mmazalov/mmazalov.github.io/fpv/cnc/README.md

# Центральні пластини — завдання на різку

| Файл | Деталь | К-сть |
|---|---|---|
| `plate_top.dxf` | Пластина верхня | 1 |
| `plate_bottom.dxf` | Пластина нижня | 1 |
| `cage_plate_center.dxf` | П1 — монтажна плита між рейками, CF 2 мм | за потребою |
| `cage_plate_side.dxf` | П2 — монтажна плита бортова, **G10 2 мм** | за потребою |

## Матеріал і різка

- **Карбон 3K**, twill або plain, 2.0 мм — центральні пластини і П1
- **Склопластик G10 (FR4), 2.0 мм — П2**; різати з відсмоктуванням пилу
- Одиниці в DXF — **мм**, масштаб 1:1
- Початок координат — лівий нижній кут габариту кожної деталі
- Центральні пластини 250 × 250; П1 190 × 130; П2 150 × 150
- Шар `CUT_OUTER` — зовнішній контур (різати **зовні** лінії)
- Шар `CUT_INNER` — отвори, пази, вирізи (різати **всередині** лінії)
- Допуск на отвори: +0.1 / −0 мм. Ø4.2 під M4, Ø3.2 під M3 — отвори вже з зазором, не розсвердлювати
- Мінімальний внутрішній радіус у контурах — 2.5 мм (фреза до Ø5)
- Кромки зняти від розшарування, фаску не робити

## Орієнтація

Півкруглий виріз R2.5 по центру однієї кромки — **ніс апарата**. Пластини відрізняються
отворами; на обох виріз має дивитись в один бік при складанні.

## Що на пластинах

| Отвори | Ø | Верхня | Нижня |
|---|---|---|---|
| Затискачі променів Ø50, 4×M4 на промінь | 4.2 | 16 | 16 |
| Стійки між пластинами, 50 мм | 3.2 | 4 | 4 |
| Кронштейн Starlink | 4.2 | 4 | — |
| Кронштейн щогли GPS | 4.2 | 2 | — |
| Демпфери Pixhawk | 3.2 | — | 4 |
| Касета батареї — пази 60×4.2 | — | — | 2 |
| Ніжки клітки payload | 4.2 | — | 8 |
| Пази під джгути 40 × 12 | — | 2 | 2 |
| Центральний виріз | — | 80 × 80 R10 | 70 × 50 R10 |

Розрахункова маса: верхня **168 г**, нижня **177 г**.

## Перевірки, які пройшли файли

- кожен отвір не ближче 1.5·d і не ближче 6 мм до кромки
- перемички між отворами, пазами і вирізом не менше 6 мм
- жоден отвір, окрім власних, не потрапляє під затискач променя
- пластина після вирізів лишається одним цілим
- аудит DXF без помилок; площі контурів з файлу збігаються з еталонною геометрією
  (тобто дуги вигнуті в правильний бік)

Файли генеруються скриптом `fpv/tools/make_plates_dxf.py` з `fpv/tools/plate_geometry.py`.
Правити геометрію — тільки там, не в DXF вручну.

## Монтажні плити клітки (П1, П2)

Універсальні: 4 сідла J5 (Ø3.2, 2×M3 крок 28) і сітка Ø3.2 з кроком 20 під будь-яке навісне.
Кількість — під ваше обладнання; отвори під конкретні вироби не потрібні.

## Нижня пластина: пази касети батареї

Два пази 60 × 4.2 під 2×M4 кожен: хід касети ±15 мм уздовж осі апарата для балансування центру мас.
