mmazalov/mmazalov.github.io/fpv/frame-sketch.pdf

Розміри в мм · z = 0 — площина гвинтів · x — вперед (ніс), y — праворуч

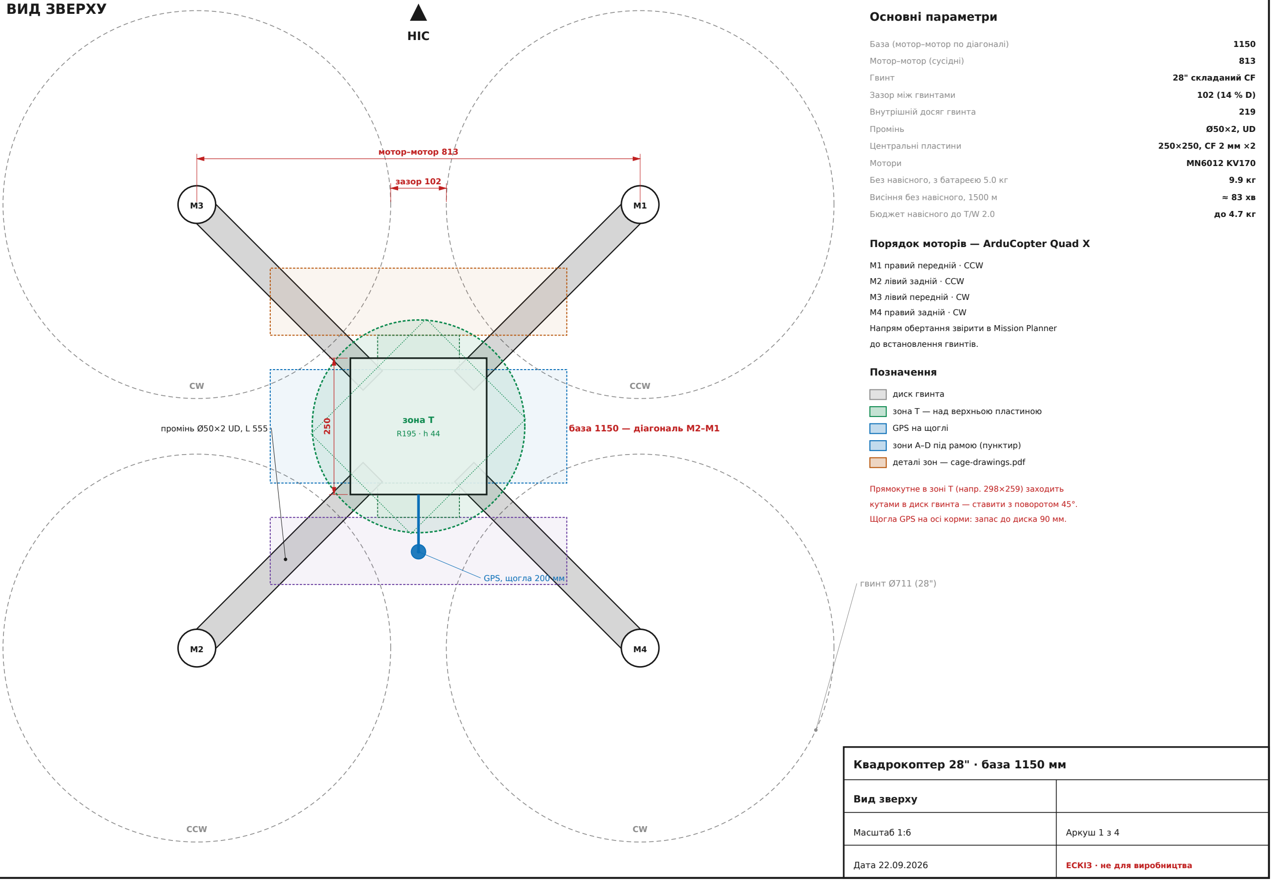
[picture p9: figure]
Квадрокоптер 28" · база 1150 мм; Вид зверху; Масштаб 1:6; Аркуш 1 з 4; Дата 22.09.2026; ЕСКІЗ · не для виробництва; ВИД ЗВЕРХУ; зона T; GPS, щогла 200 мм; CCW; НІС; мотор–мотор 813; зазор 102; промінь Ø50×2 UD, L 555; база 1150 — діагональ M2–M1; гвинт Ø711 (28"); Основні параметри; База (мотор–мотор по діагоналі); Мотор–мотор (сусідні); Гвинт; 28" складаний CF; Зазор між гвинтами; Внутрішній досяг гвинта; Промінь; Центральні пластини; Мотори; Без навісного, з батареєю 5.0 кг; Висіння без навісного, 1500 м; Бюджет навісного до T/W 2.0; Порядок моторів — ArduCopter Quad X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

Напрям обертання звірити в Mission Planner

Прямокутне в зоні T (напр. 298×259) заходить

кутами в диск гвинта — ставити з поворотом 45°.

Щогла GPS на осі корми: запас до диска 90 мм.

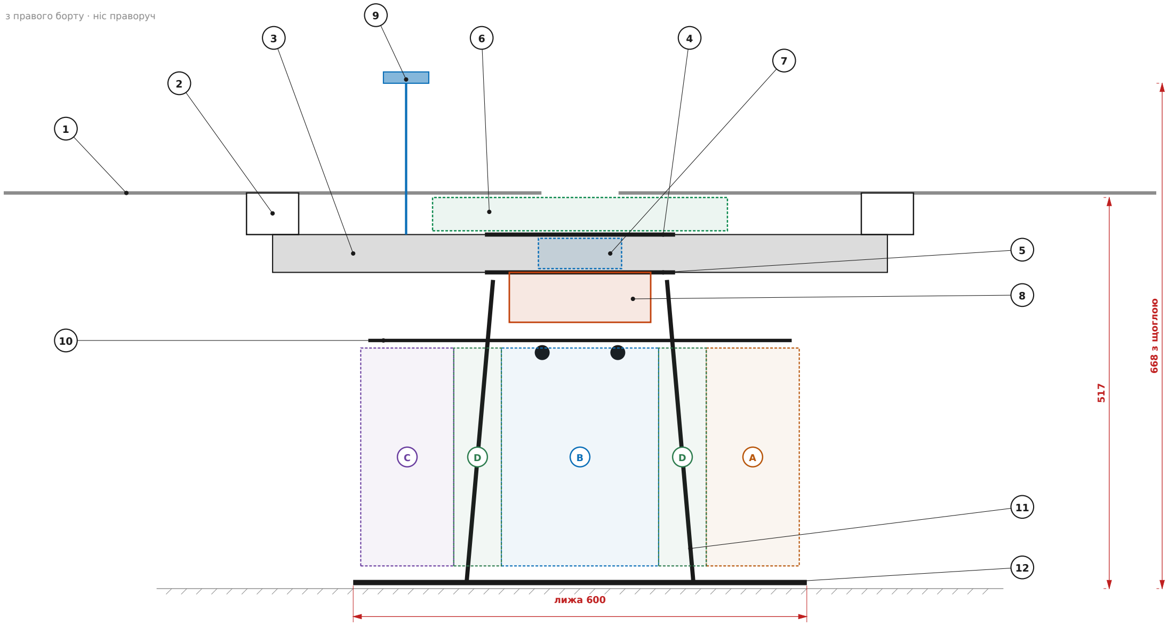
[picture p10: figure]
з правого борту · ніс праворуч; 668 з щоглою; лижа 600

## Квадрокоптер 28" · база 1150 мм

### Вид збоку

Масштаб 1:5 | Аркуш 2 з 4

# ВИД ЗБОКУ

## Рівні, z

GPS, верх | +145
Гвинти | 0
Starlink, верх | −6
Верхня пластина | −55
Вісь променя | −80
Нижня пластина | −105
Низ батареї | −171
Рейки | −195
Поперечки | −211
Верх зон A–D | −205
Низ зон A–D | −493
Низ лиж | −523

### Розв'язки

- Зони навісного: A–D під рамою, T над верхньою пластиною. Габарити й правила — cage-drawings.pdf, аркуші 1–2.
- Клітка payload = шасі. Рейки й поперечки — площина кріплення, зони починаються під нею.
- Просвіт під зонами 30 мм; до ніжок, лиж і батареї — не менше 10 мм.
- Касета батареї в пазах ±15 мм — балансування ЦМ під ваше навісне (±75 кг·мм).
- Авіоніка між пластинами: промені займають лише 4 радіальні смуги, центр вільний, просвіт 50 мм.

## Квадрокоптер 28" · база 1150 мм

### Вид спереду · специфікація

Масштаб 1:5 | Аркуш 3 з 4

# ВИД СПЕРЕДУ

з боку носа · промені обірвано

## Специфікація

Поз. | Найменування | К-сть
1 | Гвинт 28" складаний CF, 2 лоп. | 4

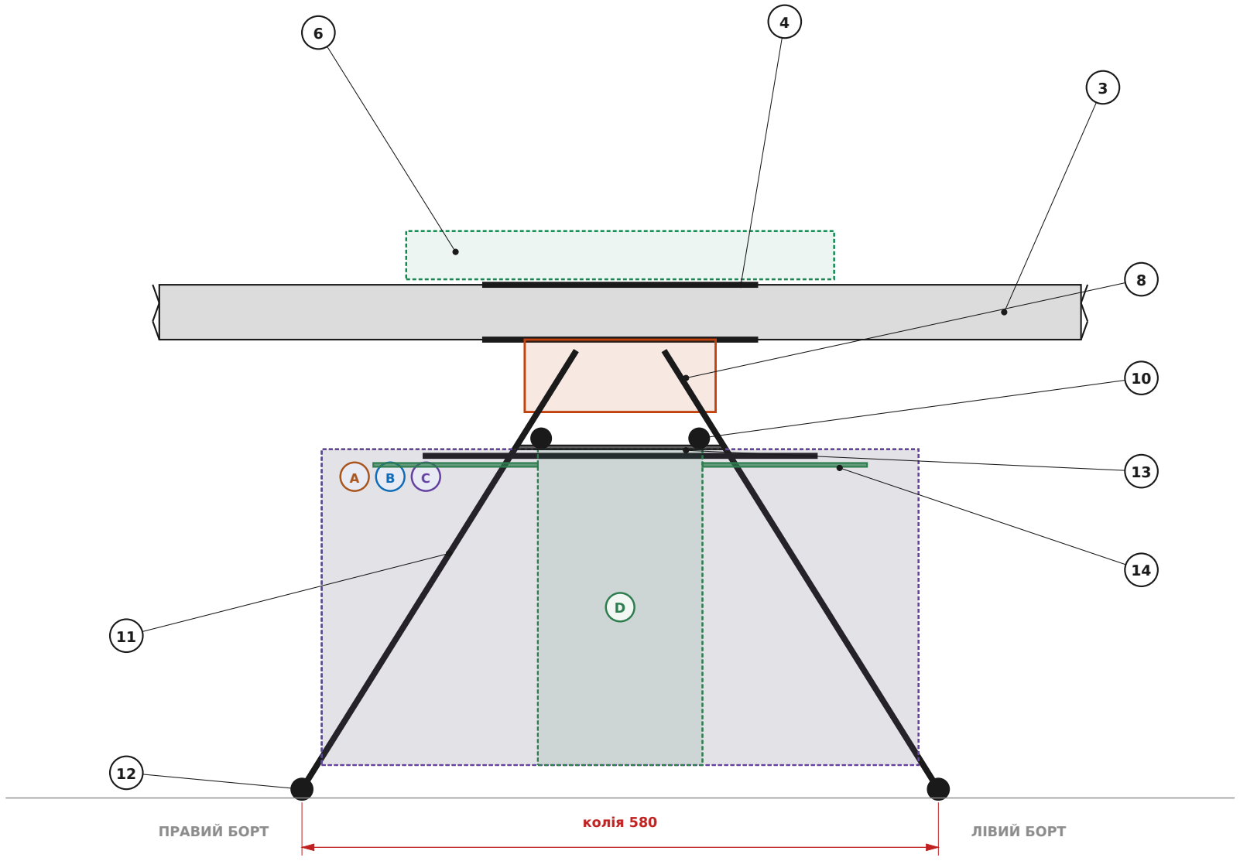
[picture p11: figure]
ПРАВИЙ БОРТ; ЛІВИЙ БОРТ колія 580

2 | Мотор T-Motor MN6012 KV170 | 4
3 | Промінь CF Ø50×2 UD, L 555 | 4
4 | Пластина верхня CF 2 мм 250×250 | 1
5 | Пластина нижня CF 2 мм 250×250 | 1
6 | Зона T — верхнє навісне, 4×M4 | —
7 | Pixhawk 6X + RPi CM4 baseboard | 1
8 | Батарея 12S1P у касеті G10 | 1
9 | Щогла GPS, h 200 | 1
10 | Рейки й поперечки G10 Ø16×14 | 4
11 | Ніжка клітки CF Ø16×14, L 457 | 4
12 | Лижа CF Ø16, L 600 | 2
13 | Монтажна плита між рейками, CF 2 | за потр.
14 | Монтажна плита бортова, G10 2 | за потр.

### Примітки

- Зони A, B, C мають однаковий переріз у цьому виді; D — вузький коридор між ніжками (±75).
- Колія лиж 580 ≥ 550 — стійкість на ухилі з батареєю 5 кг під центром.
- Антени нижче 1 ГГц — у бортових частинах зон, ≥ λ/4 (83 мм на 900 МГц) від карбону й металу.
- Монтажні плити (поз. 13, 14) — приклади; кількість і положення — під ваше навісне.

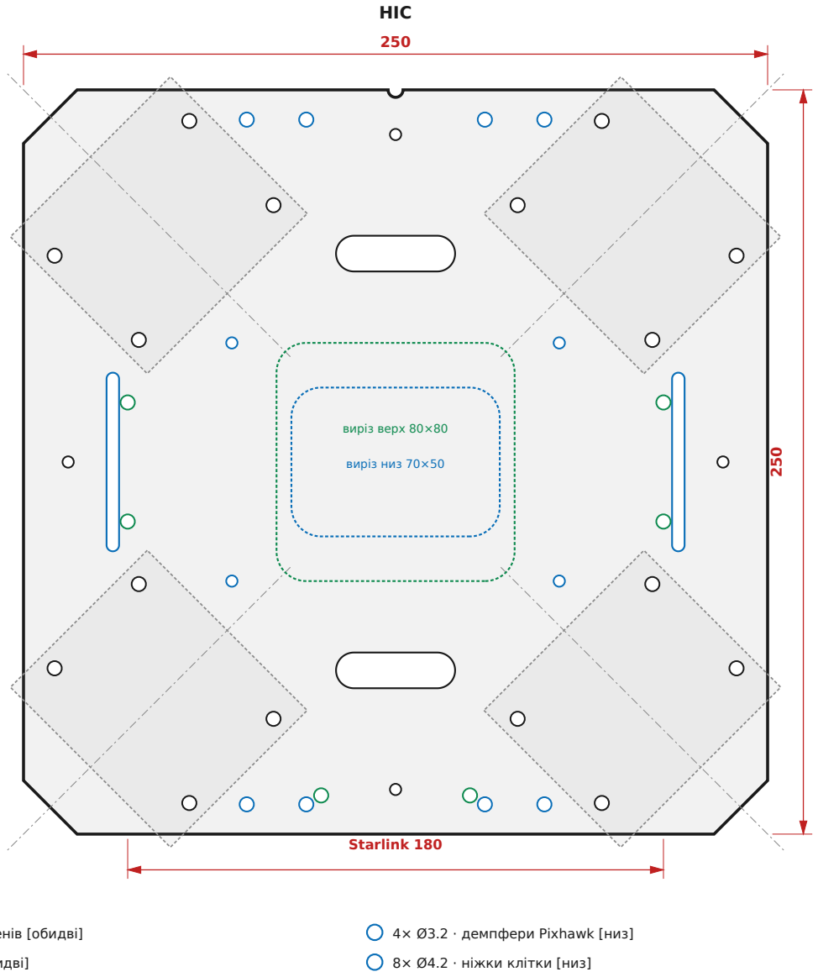
[picture p12: figure]
виріз верх 80×80; виріз низ 70×50; НІС; Starlink 180; 4× Ø3.2 · демпфери Pixhawk [низ]; 8× Ø4.2 · ніжки клітки [низ]

## Квадрокоптер 28" · база 1150 мм

### Зони встановлення · центральна пластина

Масштаб 1:4 / 1:2 | Аркуш 4 з 4

# ЗОНИ ВСТАНОВЛЕННЯ — ПЛАН

проекція на вид зверху · рама фантомом

### НІС

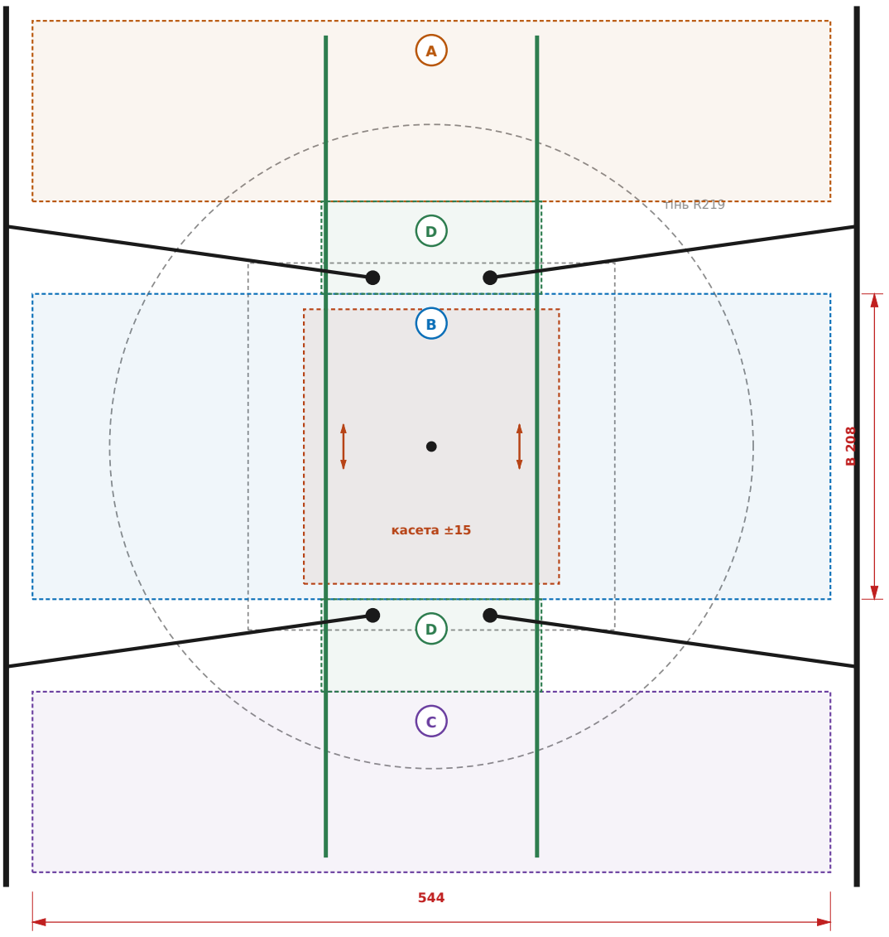
[picture p13: figure]
касета ±15; тінь R219

580 (A–D уздовж)

Зони: A носова 123×544, B центральна 208×544, C кормова 123×544, D коридори 63×150 (×2); висота 288.

ЦМ: касета батареї в пазах ±15 мм компенсує ±75 кг·мм по x. По y компенсації немає.

# ЦЕНТРАЛЬНА ПЛАСТИНА

CF 2 мм · 2 шт · вид зверху · для DXF брати розміри, не масштаб

### Отвори

16× Ø4.2 · затискачі променів [обидві]

4× Ø3.2 · стійки 50 мм [обидві]

4× Ø4.2 · кронштейн Starlink [верх]

2× Ø4.2 · кронштейн щогли GPS [верх]

Затискач Ø50: 4×M4, крок 40 уздовж × 64 впоперек. Пази 40×12 — під джгути.

Пластина 250×250 (на 210×200 затискачі Ø50 не поміщаються): верх 168 г, низ 176 г.

Нижня: 2 пази касети 60×4.2 під 2×M4 кожен — хід ±15 мм. Півкруглий виріз на кромці — ніс.

DXF для різки: fpv/cnc/plate_top.dxf, plate_bottom.dxf.
