mmazalov/mmazalov.github.io/fpv/cnc/plate_bottom.dxf

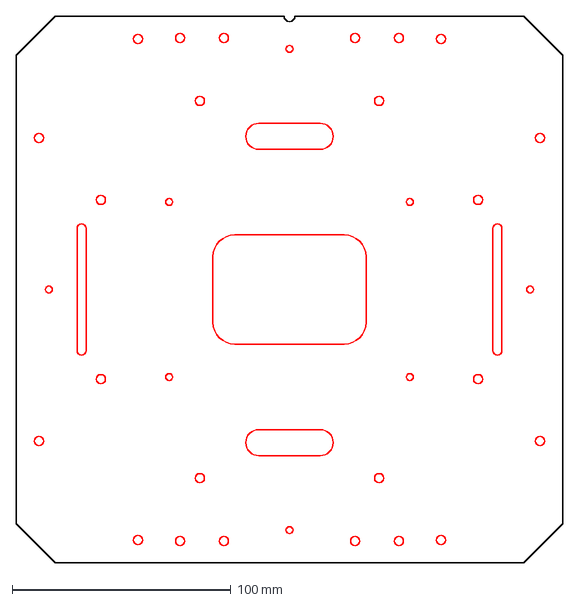
[picture p14: CAD file, 2026-09-22]
fpv/cnc/plate_bottom.dxf
250.0 x 250.0 mm
