mmazalov/mmazalov.github.io/fpv/cnc/cage_plate_side.dxf

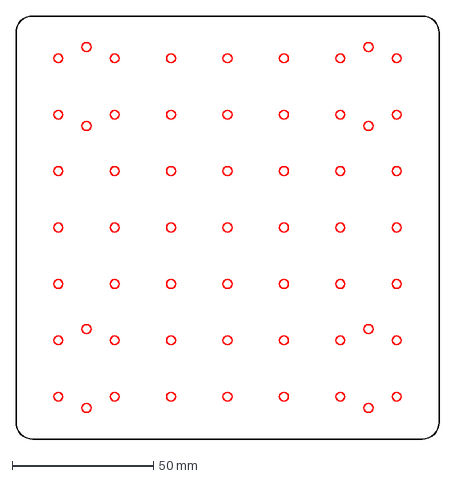
[picture p15: CAD file, 2026-09-22]
fpv/cnc/cage_plate_side.dxf
150.0 x 150.0 mm
