mmazalov/mmazalov.github.io/fpv/cnc/plate_top.dxf

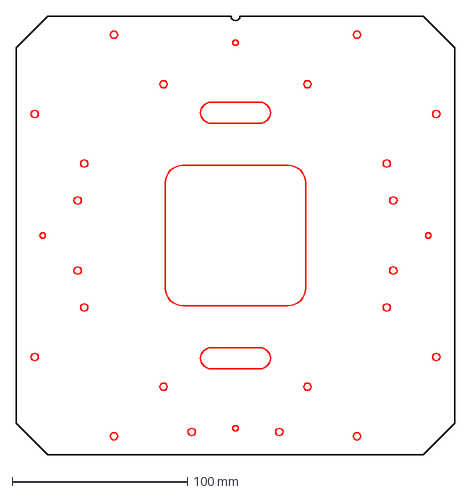
[picture p16: CAD file, 2026-09-22]
fpv/cnc/plate_top.dxf
250.0 x 250.0 mm
