mmazalov/mmazalov.github.io/fpv/cnc/cage_plate_center.dxf

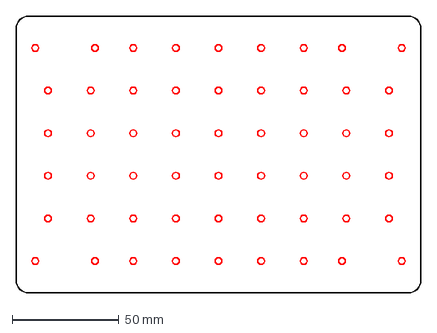
[picture p17: CAD file, 2026-09-22]
fpv/cnc/cage_plate_center.dxf
190.0 x 130.0 mm
