mmazalov/mmazalov.github.io/fpv/cnc/cage_horn.dxf

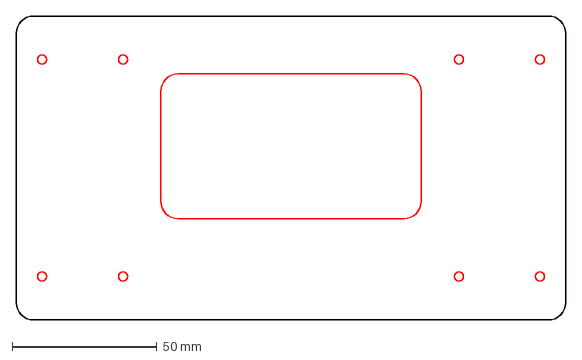
[picture p18: CAD file, 2026-09-22]
fpv/cnc/cage_horn.dxf
190.0 x 105.0 mm
