mmazalov/mmazalov.github.io/fpv/cnc/cage_zr10.dxf

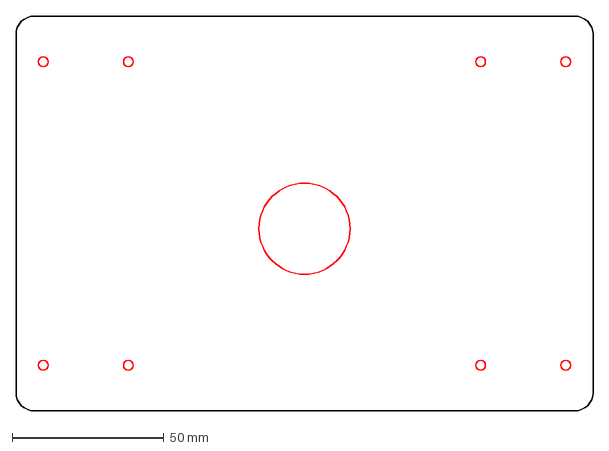
[picture p19: CAD file, 2026-09-22]
fpv/cnc/cage_zr10.dxf
190.0 x 130.0 mm
