mmazalov/mmazalov.github.io/fpv/longrange-build.md

# FPV довготривалого висіння — робоча специфікація

**Задача:** стабільне висіння на 1000–1500 м, 50–60 хв, з каналом Starlink
і антенним payload 3.3 ГГц / 900 МГц.

Креслення: `frame-24in-layout.svg` (потребує оновлення під базу 1100 мм)

---

## 0. ФІНАЛЬНА КОНФІГУРАЦІЯ

Розділи 1–10 нижче — хід міркувань і причини кожної зміни. Ця секція — те, що замовляти.

| Вузол | Рішення |
|---|---|
| Схема | квадр X, **база 1150 мм** (§19.5) |
| Гвинти | **28" складані CF**, 2-лопатеві — 26" не проходить по тязі (§19.2) |
| Мотори | **T-Motor MN6012 KV170** ×4 |
| ESC | APD 80F3[X] або T-Motor Alpha 80A HV ×4 |
| Промінь | карбон **кругла Ø50×2 мм, roll-wrapped, UD-домінантний**, заготовка 515 мм (§17) |
| Батарея | **12S1P Westinghouse INP1187187** Li-ion pouch, 1732 Вт·год, маса до уточнення (§12) |
| Зв'язок | Starlink Mini + buck 24 В / 150 Вт |
| **Керування** | **ELRS 2.4 ГГц — НЕ 868 МГц** (конфлікт з payload, §10.1) |
| Відео | DJI O4 Air Unit |
| Payload | рупор 3.3 ГГц 16 dBi (корма) + Ягі 900 МГц 5 ел. + ретранслятор + **SIYI ZR10 (ніс)** |
| Політний контролер | **Pixhawk 6X + Raspberry Pi CM4 Baseboard** (§19.1). F722 не підходить |
| Шасі | **клітка payload 400 мм**, вона ж посадкові опори (§16) |

### Розрахункові показники

| Параметр | Значення |
|---|---|
| Суха маса | 6.05 кг |
| Комірка | Westinghouse INP1187187, 39 Ач, 175 А, 144.3 Вт·год |
| **AUW** | **13.8 кг** з payload і реальною кліткою (§23) |
| Тяга в висінні | 2763 г/мотор |
| Потужність на 1500 м | 1406 Вт (31.7 А, 0.81C) |
| **Час висіння на 1500 м** | **47.5 хв** з повним payload, пакет 5.0 кг (§23) |
| T/W на 1500 м | 2.50 |
| Лопатева частота | 87.8 Гц |
| Мода променя 40×40×2 UD | 126 Гц (запас 1.43×) |
| ЦМ | 97 мм нижче площини гвинтів |

### Електричний баланс

| Споживач | Потужність | Частка |
|---|---|---|
| Гвинтомоторна група | 1300 Вт | 92 % |
| Starlink Mini | 39 Вт | 3 % |
| Payload RF | 42 Вт | 3 % |
| Авіоніка, FC, GPS, O4 | 25 Вт | 2 % |
| **Разом** | **1406 Вт** | |

### Альтернативи, якщо змінити два рішення

| Варіант | AUW | Час | T/W |
|---|---|---|---|
| **Пласкі антени, 26"** | **11.05 кг** | **62 хв** | **2.50** |
| Пласкі антени, 24" (база 1000) | 11.05 кг | 57 хв | 2.19 |
| Рупор + Ягі, 26" | 11.49 кг | 59 хв | 2.41 |
| Рупор + Ягі, 24" (база 1000) | 11.49 кг | 54 хв | 2.11 |

### Три речі, які не можна змінювати мовчки

1. **Керування на 2.4 ГГц.** 868 МГц лежить за 3.7 % від payload-передавача на 900 МГц.
   Фільтром не розділяється, наслідок — втрата керування. §10.1
2. **Труба UD-домінантна, 40×40×2.** Квазіізотропна дасть моду на лопатевій частоті. §10.4
3. **Пороги батареї за паспортом solid-state, не за аналогією з Li-ion.** §9

### Орієнтовний бюджет (без батареї і payload RF)

| | грн |
|---|---|
| Мотори MN6012 ×4 | 54 000 |
| ESC 80 A ×4 | 18 000 |
| Гвинти 26" складані, 3 пари | 13 000 |
| Рама DIY (40×40, пластини, CNC, шасі) | 20 000 |
| Pixhawk 6C + GPS + power module | 15 300 |
| Starlink Mini + buck + кронштейн | 23 500 |
| DJI O4 Air Unit | 12 000 |
| ELRS 2.4 ГГц RX + TX | 5 000 |
| Силова частина, роз'єми, дрібниця | 5 000 |
| **Разом** | **≈ 166 000** |

Зарядка Junsi iCharger X12 — ще 12 000, якщо немає.

---

## 1. Підсумок

| Параметр | Значення |
|---|---|
| Схема | квадр X, база 1000 мм |
| Гвинти | 24" складані CF, 2-лопатеві (Ø610 мм) |
| Мотори | T-Motor MN6007 II KV160, 12S |
| ESC | Flycolor X-Cross HV3 60A 5-12S BLHeli_32 ×4 |
| Батарея | 12S4P Samsung INR21700-50S — 864 Вт·год, 3.97 кг |
| Суха маса | 3.06 кг |
| **AUW** | **7.03 кг** |
| Тяга в висінні | 1758 г/мотор (35 % від максимуму) |
| T/W на 1500 м | 2.46 |
| Потужність висіння на 1500 м | 740 Вт (17.1 А) |
| **Час висіння на 1500 м** | **56–61 хв** (номінал 59) |

---

## 2. Розрахунок

Теорія імпульсу, на один мотор:

```
A       = π · (D·0.0254/2)²           площа диска, м²
T_N     = T_g · 0.00981               тяга, Н
P_ideal = T_N^1.5 / sqrt(2·ρ·A)       ідеальна потужність
P_elec  = P_ideal / (FM · η_drive)    спожита з батареї
```

`FM·η_drive` — добуток ККД гвинта і приводу, єдиний коефіцієнт, який вирішує все.
Калібрування по DJI M350 RTK (6.47 кг, 21", 620 Вт·год, 55 хв) → 0.56, верхня межа серійної
техніки. Для збірки на T-Motor MN6007 II + якісні складані CF гвинти приймаємо **0.51**.

Висота 1500 м: ρ = 1.058 кг/м³, `P ∝ 1/sqrt(ρ)` → +7.6 % потужності. Плюс ~3 хв на набір.
Li-ion розряджаємо до 3.2 В/комірку → корисних 88 % ємності.

### Вибір ємності батареї

| Пакет | Маса | Ємність | AUW | Потужність | Час | T/W @1500м |
|---|---|---|---|---|---|---|
| 12S3P | 2.98 кг | 648 Вт·год | 6.04 кг | 594 Вт | 55 хв | 2.87 |
| **12S4P** | **3.97 кг** | **864 Вт·год** | **7.03 кг** | **740 Вт** | **59 хв** | **2.46** |
| 12S5P | 4.97 кг | 1080 Вт·год | 8.02 кг | 896 Вт | 61 хв | 2.15 |

Плато очевидне: 12S5P додає 1 кг і ~4 600 грн заради +2 хв, і псує керованість.
**12S4P — оптимум.**

### Чутливість

| Фактор | Вплив |
|---|---|
| 22" → 24" гвинти | **+5 хв** (804 Вт → 740 Вт) |
| FM·η_drive 0.47 → 0.53 | 54 → 61 хв |
| Кожні 100 г сухої маси | **∓1.3 хв** |

Кожні 100 г рами коштують 1.3 хв. Кожні 100 г батареї дають лише +0.2 хв.
**Економія маси рами у 6 разів ефективніша за додавання батареї.**

---

## 3. Рама

### Геометрія

| Розмір | Значення |
|---|---|
| База (діагональ мотор–мотор) | 1000 мм |
| Радіус мотора від центру | 500 мм |
| Відстань між сусідніми моторами | 707 мм |
| Зазор кінчик–кінчик, 24" | 97 мм (16 % діаметра) |
| Промінь: заготовка | 465 мм (405 відкритих + 60 у затискач) |
| Центральні пластини | 210 × 200 мм, карбон 2 мм, ×2, розніс 35 мм |
| Ніжки | Ø16×14 мм, 300 мм, розвал 22° |
| Опорна база шасі | 624 мм |
| Просвіт під батареєю | ≈ 200 мм |

### Вибір перерізу променя

| Переріз | I, мм⁴ | Маса, кг/м | EI/маса |
|---|---|---|---|
| 25×25×1.5 | 13 031 | 0.219 | 5 366 |
| 25×25×2.0 | 16 345 | 0.285 | 5 158 |
| 30×30×1.5 | 23 213 | 0.265 | 7 882 |
| **30×30×2.0** | **29 419** | **0.347** | **7 626** |

30×30 дає на **45 % кращу жорсткість на одиницю маси** за 25×25 — більший переріз завжди
виграє при згині. Беремо 2 мм стінку заради затискача: 1.5 мм зминається під хомутом.

### Резонанс — це не формальність

Гвинт 24" у висінні на 1758 г крутить **2467 об/хв = 41 Гц**, лопатева частота **82 Гц**.

Перша згинна мода променя 30×30×2, виліт 405 мм, маса на кінці 330 г:

| Викладення труби | E | f₁ | Запас до 82 Гц |
|---|---|---|---|
| Квазіізотропне (плетінка) | 90 ГПа | 90.6 Гц | +10 % — мало |
| **Переважно однонаправлене** | **130 ГПа** | **108.9 Гц** | **+33 % — норма** |

**Замовляйте трубу roll-wrapped з UD-домінантним викладенням, не пултрузію і не чисту
плетінку.** Різниця в ціні ~20 %, різниця в поведінці — принципова.

Додатково обов'язково:
- harmonic notch в ArduCopter по телеметрії обертів ESC
- балансування гвинтів
- FC на 4 силіконових демпферах

### Маса рами

| Вузол | Маса |
|---|---|
| Промені 30×30×2, 465 мм ×4 | 645 г |
| Центральні пластини 2 мм ×2 (35 % полегшення) | 150 г |
| Затискачі складані ×4 (друк PA-CF) | 140 г |
| Моторні площадки карбон 3 мм ×4 | 120 г |
| Шасі (4 ніжки + 2 лижі + кріплення) | 206 г |
| Лоток батареї, стійки, демпфери, метиз | 160 г |
| **Разом** | **1421 г** |

Алюмінієві CNC-затискачі замість друкованих додають +80 г (−1 хв польоту), але надійніші
на посадках. Вибір за вами.

### Баланс мас

| Вузол | Маса |
|---|---|
| T-Motor MN6007 II KV160 ×4 | 800 г |
| ESC Flycolor X-Cross HV3 60A ×4 + проводка | 168 г |
| Гвинти 24" складані CF ×4 | 252 г |
| Рама | 1421 г |
| FC + GPS + power module | 130 г |
| FPV (O4 Air Unit + антени) | 70 г |
| ELRS 868 RX 1 Вт | 35 г |
| Силова проводка, роз'єми, кріплення | 180 г |
| **Суха маса** | **3056 г** |
| Батарея 12S4P | 3974 г |
| **AUW** | **7030 г** |

---

## 4. Електрика

| Режим | На мотор | Сумарно | Запас |
|---|---|---|---|
| Висіння | 185 Вт / 4.3 А | 740 Вт / 17.1 А | — |
| Повний газ | ~1150 Вт / 26.6 А | 4600 Вт / 106 А | ESC 60 A: **2.25×** |

Батарея 12S4P на 50S: **100 А тривало, 180 А пікових**. У висінні 4.3 А на комірку проти
дозволених 25 — мінімальна просадка і довгий ресурс.

**Чому 50S, а не 50E:** 50E має щільність 261 Вт·год/кг проти 257, але тягне лише 9.8 А —
12S4P дасть 39 А, а зліт вимагає 106 А. 50S дає ту саму щільність без обмеження по газу.

**Компонування пакета:** 2 блоки 12S2P по 6×4 комірки, кожен 129 × 86 × 70 мм, ~2 кг.
Легше заряджати, балансувати й носити; можна літати коротшу місію на одному.
Паралелити лише вирівняні по напрузі.

---

## 5. BOM

| Позиція | Модель | К-сть | Сума, грн |
|---|---|---|---|
| Мотори | T-Motor MN6007 II KV160 | 4 | 36 000 |
| ESC | Flycolor X-Cross HV3 60A 5-12S BLHeli_32 | 4 | 9 600 |
| Гвинти | 24" складані CF 2-лоп. (T-Motor FA/MF, MAD FLUXER 2410) | 2 пари | 10 400 |
| Гвинти запасні | те саме | 1 пара | 5 200 |
| Труба променя | карбон 30×30×2, roll-wrapped UD, 2.5 м | — | 2 750 |
| Пластина | карбон 2 мм, 300×400 | 1 | 2 200 |
| Пластина | карбон 3 мм, 200×200 (моторні площадки) | 1 | 1 300 |
| CNC різка за DXF | — | — | 3 500 |
| Труба шасі | Ø16×14, 2.5 м | — | 900 |
| Затискачі променів | складані, під 30×30 | 4 | 3 600 |
| Кріплення | стійки, метиз M3/M4, демпфери | — | 1 800 |
| Політний контролер | Matek H743-SLIM V3 | 1 | 4 500 |
| GPS | Matek M10Q-5883 | 1 | 1 800 |
| Power module | HV 12S (Mauch PL-200 / Matek) | 1 | 2 500 |
| Комірки | Samsung INR21700-50S | 48 | 12 480 |
| Обв'язка батареї | нікель, тримачі, балансир, AS150+XT150 | — | 2 800 |
| Зварювання пакета | якщо не своє обладнання | — | 1 500 |
| FPV | DJI O4 Air Unit Pro | 1 | 12 000 |
| Зв'язок | ELRS 868 МГц RX 1 Вт | 1 | 2 200 |
| Зв'язок | ELRS 868 МГц TX модуль | 1 | 2 800 |
| Силова частина | кабель 10 AWG, роз'єми, конденсатори 100 мкФ/63 В ×4 | — | 3 500 |
| **Разом** | | | **≈ 123 000** |

Прямий імпорт моторів (Foxtech / AliExpress, ~$150/шт) знімає ~10 000 грн,
але це 3–4 тижні і митниця.

### Інфраструктура (якщо ще немає)

| Позиція | Ціна, грн |
|---|---|
| Зарядка Junsi iCharger X12 (12S, 1100 Вт) | 12 000 |
| Апаратура RadioMaster TX16S / Boxer | 8 000 – 14 000 |
| Окуляри DJI Goggles 3 або монітор | 18 000 – 25 000 |

20 Ач при 0.5C = 10 А → ~2.2 год на цикл. Звичайна 6S зарядка не підходить.

---

## 6. ArduCopter — ключові параметри

Прошивка **ArduCopter 4.5+**, не Betaflight і не INAV: потрібні `MOT_THST_HOVER`,
коректний Loiter і failsafe по Вт·год.

### Батарея (Li-ion, не LiPo!)

```
BATT_MONITOR      = 4
BATT_CAPACITY     = 20000
BATT_LOW_VOLT     = 40.8      # 3.4 В/комірку
BATT_CRT_VOLT     = 38.4      # 3.2 В/комірку — НЕ 3.5 як у LiPo
BATT_FS_LOW_ACT   = 2         # RTL
MOT_BAT_VOLT_MAX  = 50.4
MOT_BAT_VOLT_MIN  = 38.4      # компенсація тяги при просадці — критично
```

За 50 хв напруга падає з 50.4 до ~39 В. Без `MOT_BAT_VOLT_*` регулятор «попливе»
в другій половині польоту.

### Вібрації

```
INS_HNTCH_ENABLE  = 1
INS_HNTCH_MODE    = 3         # по телеметрії обертів ESC (bidirectional DShot)
INS_HNTCH_REF     = 1.0
INS_HNTCH_FREQ    = 41        # частота обертання в висінні
INS_HNTCH_BW      = 20
INS_HNTCH_HMNCS   = 3         # 1-а + 2-а гармоніки
INS_HNTCH_OPTS    = 2         # окремий notch на кожен мотор
INS_GYRO_FILTER   = 20
MOT_PWM_TYPE      = 5         # DShot300 — на 40 см проводах надійніше за DShot600
```

Після першого висіння зняти лог із `INS_LOG_BAT_MASK=1` і перевірити FFT: пік має бути
задавлений, а мода променя (~109 Гц) — не збуджуватись.

### Тяга

```
MOT_THST_EXPO     = 0.65      # великі гвинти
MOT_SPIN_ARM      = 0.06
MOT_SPIN_MIN      = 0.10
```

`MOT_THST_HOVER` навчиться сам, має вийти ~0.35–0.40.

---

## 7. Ризики

- **Резонанс променя.** Пултрузійна або плетена труба дасть моду 90 Гц проти лопатевих
  82 Гц — 10 % запасу мало. Перевірити тапп-тестом до першого польоту.
- **1.2/1.3 ГГц VTX глушить GPS L1.** Тут цифровий лінк O4, проблеми немає. Якщо
  повернетесь до аналогу — рознесення антен і екранування обов'язкові.
- **ELRS 868 МГц** — європейський діапазон. 915 МГц не ваш.
- **Складані гвинти на 24"** мають помітну відцентрову розкрутку. Перевіряти затяжку
  шарнірів перед кожним вильотом.
- **Польоти вище 120 м** потребують погодження з Украерорухом / Повітряними Силами;
  в умовах воєнного стану без дозволу не літає. З'ясувати до закупівлі.

---

## 8. Опція: Starlink Mini як канал зв'язку

### Бюджет маси і потужності

| Позиція | Маса | Потужність |
|---|---|---|
| Starlink Mini (без підставки, корпус збережено) | 1050 г | 25–40 Вт середньо, до 100 Вт пік |
| Кронштейн з вібророзв'язкою | 100 г | — |
| DC-DC понижувач 150 Вт | 110 г | ККД 90 % |
| Кабель, роз'єми, фери́ти | 60 г | — |
| **Разом** | **1320 г** | **39 Вт від батареї** |

### Ціна доповнення

| Позиція | Ціна, грн |
|---|---|
| Starlink Mini (Roam) — комплект | 20 490 |
| DC-DC 12S → 24 В, 150 Вт | 1 800 |
| Кронштейн, демпфери, кабель, фери́ти | 1 200 |
| **Разом** | **≈ 23 500** |

Тариф: Mini Roam, 50 ГБ/міс, з можливістю докупити трафік.

### Вплив на час польоту

Батарея 12S4P, 24", 1500 м:

| Режим | AUW | Потужність | Час | T/W @1500 м |
|---|---|---|---|---|
| Без Starlink | 7.03 кг | 740 Вт | **59 хв** | 2.46 |
| Зі Starlink | 8.35 кг | 989 Вт | **43 хв** | 2.07 |

**Декомпозиція втрати 15.6 хв:**

| Що саме | Втрата |
|---|---|
| Тільки маса 1.32 кг | −13.7 хв |
| Тільки потужність 39 Вт | −3.1 хв |

**Маса дає ~4.4× більший ефект, ніж споживання.** Оптимізувати треба грами кронштейна,
а не ватти. Зняття корпусу Starlink (−200 г) повертає лише 1.6 хв — не варто втрати
гарантії й герметичності.

### Чому не можна докласти батарею

MN6007 II з 24" гвинтом обмежує AUW на рівні **8.64 кг** (T/W = 2.0 на 1500 м).
Зі Starlink суха маса вже 4.38 кг, тож бюджет батареї — 4.26 кг. 12S4P (3.97 кг)
практично впирається в цю межу.

| Варіант зі Starlink | AUW | Час | T/W | Вердикт |
|---|---|---|---|---|
| 12S3P | 7.36 кг | 38 хв | 2.35 | менше батареї — менше часу |
| **12S4P** | **8.35 кг** | **43 хв** | **2.07** | **оптимум** |
| 12S5P | 9.34 кг | 46 хв | 1.85 | T/W нижче межі |

12S4P залишається правильним вибором в **обох** режимах — одна батарея, дві місії.

### Перехід на 6012 не рятує

| Конфігурація зі Starlink | AUW | Час | T/W |
|---|---|---|---|
| MN6012 + 24" + 12S5P | 9.93 кг | 42 хв | 2.44 |
| MN6012 + 26" + 12S5P | 9.93 кг | 46 хв | 2.44 |
| MN6012 + 28" + 12S5P | 9.93 кг | 49 хв | 2.44 |

6012 дає запас тяги, але не час. Єдиний реальний важіль — **більший гвинт**, а це вже
інший апарат: 28" не стає на базу 1000 мм (потрібно ~1250 мм).

**Висновок: зі Starlink Mini на борту 50–60 хв на 24" квадрі недосяжні. Реалістично 43 хв.**
Тому Starlink — знімний модуль, а не постійна частина конструкції.

### Компонування — жорстке обмеження

**Панель обов'язково повертається на 45° відносно променів.**

| Орієнтація | Відстань кута панелі до осі гвинта | Результат |
|---|---|---|
| Кути на променях | 302 мм | **конфлікт**, гвинт має радіус 305 мм |
| Кути по осях X/Y (поворот 45°) | 386 мм | чисто, запас 81 мм |

Описане коло панелі — 197.6 мм, внутрішній досяг гвинта вздовж променя — 195 мм.
Різниця 2.6 мм, тобто в «природній» орієнтації панель ріжеться гвинтами.

**По висоті:** Starlink 38.5 мм + демпфери 10 мм = 48.5 мм при просвіті 58 мм до площини
гвинтів. **Запас 9.5 мм.** Кронштейн має бути плоским; стійок під панель не ставити.

Кріплення — 4 × M4 на координатах (±70, ±65) від центру верхньої пластини.
**Отвори прорізати одразу**, навіть якщо Starlink купується пізніше.

### Живлення — понижувач обов'язковий

12S Li-ion на повному заряді дає **50.4 В**, вхід Starlink Mini обмежений **48 В**.
Пряме підключення виведе термінал з ладу.

Схема: 12S (38–50.4 В) → buck 24 В / 150 Вт → штатний DC-кабель Starlink.
Запас по потужності на пікові 100 Вт при старті терміналу.

### Резонанс — Starlink зсуває робочу точку

Зростання тяги піднімає оберти:

| Режим | Тяга/мотор | Оберти | Лопатева частота |
|---|---|---|---|
| Без Starlink | 1758 г | 2467 об/хв | 82.2 Гц |
| Зі Starlink | 2088 г | 2690 об/хв | **89.6 Гц** |

Мода променя з квазіізотропної труби — **90.6 Гц**. Це пряме влучення.

Тобто апарат, зібраний на дешевій трубі, літатиме нормально без Starlink і почне
руйнувати себе з ним. **UD-домінантна труба (109 Гц) перестає бути рекомендацією
і стає вимогою.** Після встановлення Starlink перезняти FFT і оновити `INS_HNTCH_FREQ`
з 41 на 45 Гц.

### Інше

- **GPS.** Starlink працює в Ku-діапазоні (10.7–12.7 / 14.0–14.5 ГГц) і з GPS L1
  (1575 МГц) не конфліктує, але сам термінал і buck на 150 Вт піднімають шумовий фон.
  GPS винести на щоглу 150–200 мм, на кабель живлення Starlink поставити фери́ти.
- **Гвинти в полі зору антени.** Карбон відбиває на Ku. Панель тримати якомога нижче:
  тоді гвинти видно під малим кутом місця, де Starlink і так майже не працює.
  Очікувати помірну втрату пропускної здатності, не повну відмову.
- **Охолодження.** На 1500 м холодне повітря плюс обдув гвинтами — умови кращі за наземні.
- **Тариф Roam розрахований на наземну мобільність.** Використання в повітрі офіційно
  не підтримується (для авіації є окремий продукт Starlink Aviation), і SpaceX може
  обмежувати такі сценарії. Перевірити на практиці до того, як закладати цей канал
  в основу місії.

---

## 9. Перерахунок під наявний пакет: solid-state 12S 39 Ач

### Вхідні припущення

Розрахунок нижче зроблено при **3.7 В/комірку номінально** і **масі пакета 5.0 кг**.
Обидва числа потребують підтвердження за паспортом — див. «Що треба уточнити».

| | Li-ion 12S4P (попередній план) | Solid-state 12S 39 Ач |
|---|---|---|
| Енергія | 864 Вт·год | **1732 Вт·год** |
| Маса | 3.97 кг | ~5.0 кг |
| Щільність (пакет) | 218 Вт·год/кг | **~350 Вт·год/кг** |
| Корисних (88 %) | 760 Вт·год | **1524 Вт·год** |

**Вдвічі більше енергії за +1 кг маси.**

### Результат

| Конфігурація | AUW | Потужність | Час | T/W @1500 м |
|---|---|---|---|---|
| 6008 + 24", без Starlink | 8.06 кг | 901 Вт | **98 хв** | 2.14 |
| 6008 + 26", без Starlink | 8.06 кг | 834 Вт | **107 хв** | 2.14 |
| 6008 + 24", зі Starlink | 9.38 кг | 1164 Вт | 76 хв | **1.84 — не проходить** |
| 6012 + 24", зі Starlink | 9.96 кг | 1268 Вт | **69 хв** | 2.43 |
| 6012 + 26", зі Starlink | 9.96 кг | 1176 Вт | **75 хв** | 2.43 |

Проти попереднього плану: 59 → 98 хв без Starlink, 43 → 69 хв зі Starlink.

### Головний наслідок: обмеження змінилось

Апарат більше **не обмежений енергією — він обмежений тягою.**

Раніше кожні 100 г коштували 1.3 хв, і сенс був у економії маси. Тепер стеля AUW
за T/W = 2.0 впирається раніше, ніж закінчується енергія. Це перевертає два рішення:

**1. 6012 нарешті виправданий — але тільки в режимі зі Starlink.**
На 6008 конфігурація зі Starlink дає T/W 1.84, тобто поза межею. Раніше 6012 програвав
завжди; тепер він єдиний варіант для важкого режиму.

**2. Промінь треба піднімати до 35×35×2.**
Зростання тяги підняло оберти, а з ними лопатеву частоту:

| Режим | Лопатева частота | 30×30×2 UD (109 Гц) | 35×35×2 UD (138 Гц) |
|---|---|---|---|
| 6008 без Starlink | 88.0 Гц | запас 1.24× — тісно | запас 1.57× ✓ |
| 6012 зі Starlink | 97.9 Гц | запас 1.11× — тісно | запас 1.41× ✓ |

35×35×2 додає 116 г на чотири промені (−1.5 хв) і знімає резонансний ризик в обох режимах.
При важкому пакеті 30×30 вже недостатньо.

### Чутливість до маси пакета

| Маса пакета | Щільність | AUW | Час | T/W |
|---|---|---|---|---|
| 4.3 кг | 403 Вт·год/кг | 7.36 кг | **113 хв** | 2.35 |
| 5.0 кг | 346 Вт·год/кг | 8.06 кг | **98 хв** | 2.14 |
| 5.8 кг | 299 Вт·год/кг | 8.86 кг | **85 хв** | 1.95 — на межі |

Різниця в 1.5 кг маси пакета — це 28 хв і різниця між «проходить» і «не проходить» по тязі.

### Струми — перевірити обов'язково

| Режим | Висіння | Повний газ |
|---|---|---|
| 6008 без Starlink | 20.3 А (0.52C) | **103.6 А (2.66C)** |
| 6012 зі Starlink | 28.6 А (0.73C) | **144.1 А (3.70C)** |

Висіння вимагає менше 1C — для будь-якого пакета не проблема.
**Повний газ вимагає 2.7–3.7C.** Semi-solid-state пакети часто мають 1–3C тривало:
висока енергія дається ціною питомої потужності.

Якщо пакет розрахований на 2C — конфігурація з 6012 і Starlink некоректна, і злітну
потужність доведеться обмежувати параметром `MOT_SPIN_MAX`, з відповідною втратою T/W.

### Зарядка

39 Ач при 0.5C = 19.5 А, це ~870 Вт при 44.4 В. Junsi iCharger X12 (1100 Вт) впорається,
але на межі. Час циклу 2–3.5 год залежно від допустимого струму заряду.

### Налаштування ArduCopter

```
BATT_CAPACITY     = 39000
MOT_BAT_VOLT_MAX  = 50.4        # уточнити за паспортом
MOT_BAT_VOLT_MIN  = 36.0        # solid-state зазвичай 3.0 В/комірку, НЕ 3.2
BATT_CRT_VOLT     = 36.0
INS_HNTCH_FREQ    = 44          # без Starlink; 49 — зі Starlink на 6012
```

Крива розряду в solid-state відрізняється від Li-ion — пороги брати з паспорта, не за
аналогією з попереднім розділом.

### Окремо: холод

Semi-solid-state зазвичай гірше віддає ємність на морозі, ніж звичайний Li-ion.
На 1500 м температура нижча за приземну на 8–10 °C. Перед зимовими місіями зняти
реальну ємність при робочій температурі, а не покладатись на паспортну.

### Що треба уточнити

1. **Маса пакета** — визначає і час, і проходження по тязі (див. таблицю чутливості).
2. **Максимальний тривалий струм розряду / C-rate** — вирішує, чи можлива
   конфігурація 6012 + Starlink.
3. **Номінальна напруга комірки** (3.7 чи 3.85 В) — ±4 % до енергії.
4. **Напруга відсічки** — для `BATT_CRT_VOLT`.
5. **Габарити** — пакет на 1732 Вт·год це ~2.5 л; треба перевірити посадку під
   центральною пластиною при ніжках 300 мм.

---

## 10. Антенний payload: рупор 3.3 ГГц 16 dBi + Ягі 900 МГц

Мотори зафіксовано: **MN6012 KV170**. З цим навантаженням альтернативи немає.

### 10.1 Конфлікт частот — вирішувати першим

| Система | Частота |
|---|---|
| **Керування ELRS** | **868 МГц** |
| **Ягі payload** | **900 МГц** |
| GPS L1 | 1575 МГц |
| Відео O4 | 2400 / 5800 МГц |
| Рупор payload | 3300 МГц |
| Starlink | 10.7–12.7 / 14.0–14.5 ГГц |

Рознесення між каналом керування і payload — **3.7 %**. На такій відстані фільтр
поставити неможливо: смуга пропускання будь-якого реального фільтра ширша за проміжок.
Передавач 900 МГц на тому самому планері забиває приймач ELRS повністю.

**Це не завада, це втрата керування.** Рішення до початку збирання:

| Варіант | Наслідок |
|---|---|
| Керування ELRS 2.4 ГГц | Простий обмін, дальність нижча за 868 МГц |
| MAVLink поверх Starlink + ELRS 2.4 ГГц як резерв | Дальність не обмежена, залежність від супутникового каналу |
| Залишити ELRS 868 МГц | **Неприйнятно, якщо Ягі передає** |

Другорядне, але теж перевірити: сильний передавач 3.3 ГГц може перевантажувати вхідний
тракт приймача 2.4 ГГц (O4) — це питання фільтрації і рознесення, воно вирішуване.

### 10.2 Габарити з перших принципів

**Рупор 16 dBi @ 3.3 ГГц** (λ = 90.8 мм): апертура 513 см² → **226 × 226 мм, довжина 283 мм.**

| Виконання | Маса |
|---|---|
| Литий алюміній | 800–1200 г |
| Листовий алюміній | 400–600 г |
| **Патч-решітка 4×4, ~200 × 200 × 15 мм** | **~250 г** |

**Ягі @ 900 МГц** (λ = 333 мм, вібратор 167 мм):

| Елементів | Бум | Ширина | Підсилення |
|---|---|---|---|
| 5 | 266 мм | 173 мм | ~9.5 dBi |
| 6 | 366 мм | 173 мм | ~10.5 dBi |
| 8 | 600 мм | 173 мм | ~12.0 dBi |
| **Патч на ground plane** | **25 мм** | **233 мм** | **~9 dBi, ~250 г** |

**Обидві антени в заявленому виконанні — невдала форма для коптера.**
Ягі на 366–600 мм звисає нижче ніжок 300 мм і не дасть сісти. Рупор додає 0.06 м²
бічної площі в струмені гвинтів.

Пласкі антени тієї самої смуги дають майже те саме підсилення:

| Варіант | AUW | Час @0 Вт | Час @100 Вт | T/W |
|---|---|---|---|---|
| Рупор + Ягі (листовий метал) | 11.37 кг | 57 хв | 53 хв | 2.13 |
| **Патч-решітка + патч** | **10.94 кг** | **60 хв** | **56 хв** | **2.21** |

Ціна переходу — близько 1.5 dB на 900 МГц. Виграш — 3 хв, посадка без підвішеної щогли
і відсутність великої парусності.

### 10.3 Маса і час

| Позиція | Маса |
|---|---|
| Планер 6012 (мотори + 80A ESC + рама) | 3.754 кг |
| Starlink Mini комплект | 1.320 кг |
| Рупор 3.3 ГГц + кронштейн | 0.600 кг |
| Ягі 900 МГц (6 ел.) + кронштейн | 0.450 кг |
| Фідери, DC-DC payload, кріплення | 0.250 кг |
| **Суха** | **6.374 кг** |
| Пакет 39 Ач | 5.000 кг |
| **AUW** | **11.374 кг** |

| Потужність payload | 24" | 26" |
|---|---|---|
| 0 Вт | 57 хв | 61 хв |
| 50 Вт | 55 хв | 59 хв |
| 100 Вт | 53 хв | 57 хв |
| 150 Вт | 51 хв | 55 хв |
| 200 Вт | 50 хв | 53 хв |

**Кожні 50 Вт payload коштують ~2 хв.** T/W 2.13 на 24" — проходить.

### 10.4 Промінь знову треба піднімати

При AUW 11.4 кг лопатева частота на 24" — **104.6 Гц**:

| Труба UD | f₁ | Запас | Маса 4 променів |
|---|---|---|---|
| 35×35×2 | 123 Гц | 1.17× — тісно | 761 г |
| **40×40×2** | **150 Гц** | **1.44× ✓** | 876 г |
| 40×40×2.5 | 164 Гц | 1.57× | 1081 г |

**40×40×2** додає 115 г (−1 хв) і закриває питання остаточно.

Історія зміни перерізу по ходу проєкту: 25×25 → 30×30 → 35×35 → 40×40.
Кожен раз причина одна — зростання тяги піднімало лопатеву частоту на моду променя.

### 10.5 Центр мас — новий чинник

| Вузол | Маса | Z відносно площини гвинтів |
|---|---|---|
| Пакет 39 Ач | 5.00 кг | −150 мм |
| Планер | 3.75 кг | 0 |
| Starlink | 1.05 кг | +45 мм |
| Рупор | 0.60 кг | −260 мм |
| Ягі | 0.45 кг | −420 мм |
| Фідери, DC-DC | 0.25 кг | −120 мм |

**ЦМ = 97 мм нижче площини гвинтів.** Маятникова мода **0.62 с = 1.60 Гц**, а це
робочий діапазон контуру утримання позиції.

Наслідок: на стандартному тюнінгу ArduCopter апарат почне повільно розгойдуватись
у Loiter — саме те, що вбиває стабільність 50-хвилинного висіння. Знижувати
`PSC_POSXY_P` і `PSC_VELXY_P`, тюнити за логом.

Горизонтально payload має бути **збалансований відносно геометричного центру**.
Рупор і Ягі по різні боки, з компенсацією; зміщення ЦМ навіть на 20–30 мм дає постійний
диференціал тяги між моторами, нерівномірний розряд і втрату запасу керування.

### 10.6 Що потрібно уточнити по payload

Без цих чисел розрахунок живлення і ЕМС зробити неможливо:

1. **Що саме живиться** — SDR, трансивер, підсилювач? Антени самі по собі пасивні.
2. **Напруга і струм кожного вузла** — під це рахується DC-DC і переріз шини.
3. **Потужність передавача на 900 МГц і 3.3 ГГц** — визначає, наскільки критична
   розв'язка з GPS і каналом керування.
4. **Шпаруватість** — постійна передача чи сеансами; від цього залежить середнє
   споживання, а отже й час.
5. **Смуга і точна частота** — 3.3 ГГц межує з n78 (3.4–3.8 ГГц), 900 МГц перекривається
   з GSM-900. Обидві смуги ліцензовані; питання дозволу з'ясувати до розгортання,
   як і дозвіл на висоту понад 120 м.

---

## 11. Payload 42 Вт — фінальний розрахунок

### Трактування вхідних даних

«40 Вт·год» неоднозначне, але обидва прочитання сходяться:

| Прочитання | Результат |
|---|---|
| 40 Вт постійно × 55 хв | 36.7 Вт·год |
| 40 Вт·год за політ ~55 хв | 43.6 Вт середньо |

Діапазон 37–44 Вт. У розрахунку прийнято **42 Вт**. Різниця між крайніми
трактуваннями — менше 1 хв польоту, тож уточнення не критичне.

### Результат

| Варіант | AUW | Потужність | Час | T/W | Лопатева |
|---|---|---|---|---|---|
| Рупор + Ягі, 24" | 11.49 кг | 1599 Вт | 54 хв | 2.11 | 105.1 Гц |
| Рупор + Ягі, 26" | 11.49 кг | 1484 Вт | 59 хв | 2.41 | 89.6 Гц |
| Пласкі антени, 24" | 11.05 кг | 1515 Вт | 57 хв | 2.19 | 103.1 Гц |
| **Пласкі антени, 26"** | **11.05 кг** | **1406 Вт** | **62 хв** | **2.50** | **87.8 Гц** |

Payload — лише 3 % бюджету потужності. Його внесок у час польоту мізерний;
вирішує **маса антен**, а не їх споживання. Та сама закономірність, що й зі Starlink.

### Резонанс — обидві бази проходять на 40×40×2 UD

| Варіант | Плече | Мода | Лопатева | Запас |
|---|---|---|---|---|
| 24", база 1000 | 405 мм | 150 Гц | 103.1 Гц | 1.46× |
| 26", база 1100 | 455 мм | 126 Гц | 87.8 Гц | 1.43× |

Довший промінь знижує моду, але більший гвинт знижує оберти — компенсується майже точно.

### DC-DC під payload — рахувати по піку, не по середньому

42 Вт — це **середнє**. RF-підсилювач має пік-фактор 3–5× залежно від шпаруватості
і модуляції. Перетворювач на 50 Вт піде в захист або просадить шину на передачі.

**Ставити 150 Вт** з запасом і власним конденсаторним банком біля навантаження.
Те саме стосується перерізу проводу від батареї до payload.

### Підсумкова шина живлення

```
Батарея 12S solid-state  36.0 - 50.4 В
   ├── ESC ×4                              пряме підключення
   ├── buck 24 В / 150 Вт  -> Starlink Mini
   ├── buck 12 В / 150 Вт  -> payload RF      <- по піку, не по 42 Вт
   └── power module -> FC, GPS, O4, ELRS
```

Кожен buck — з власним фери́том на вході і виході. Шина payload і шина GPS розводяться
окремо від самого початку, не спільною землею через силову пластину.

---

## 12. Реальна комірка: Westinghouse INP1187187

### Що на етикетці

```
WESTINGHOUSE LI-ION CELL
INP1187187   39Ah  175A  3.7V  144.3Wh  26/03
```

**Це звичайний Li-ion pouch, не solid-state.** Маркування прямо каже `LI-ION CELL`.
Розрахунки §9–11 велись у припущенні semi-solid з масою 5.0 кг — енергія збіглася
точно, маса потребує перевірки.

| Параметр | Значення |
|---|---|
| Ємність | 39 Ач |
| Номінал | 3.7 В |
| Енергія комірки | 144.3 Вт·год (39 × 3.7 ✓) |
| Максимальний струм | **175 А = 4.5C** |
| Код корпусу | INP1187187 → ~11 × 87 × 187 мм |
| Дата | 03/2026, комірки свіжі |

### 12S1P

| Параметр | Значення |
|---|---|
| Енергія | **1732 Вт·год** — точно як у розрахунку |
| Напруга | 44.4 В ном · 50.4 макс · 36.0 відсічка |
| Максимальний струм | 175 А |

Напруга 50.4 В підтверджує: **buck на Starlink обов'язковий** (вхід терміналу 48 В).

### Питання C-rate закрите

| Режим | Струм | Від ліміту 175 А |
|---|---|---|
| Висіння | 34.5 А (0.88C) | 20 % |
| Повний газ | ~171 А (4.4C) | **98 %** |

Тривалий режим із величезним запасом. Але **повний газ впирається в ліміт комірки**.
Для висіння це неважливо, проте різкі маневри й різкий злет стресуватимуть пакет.
Розумно обмежити `MOT_SPIN_MAX` до 0.92–0.95: T/W 2.2 замість 2.34, зате комірки
не працюють на межі.

### Маса — єдине, що залишилось

Це найважливіше число в проєкті, і його немає на етикетці.

| Припущення | Вт·год/кг | Комірка | Пакет (+10 % обв'язка) |
|---|---|---|---|
| Як рахувалось досі | 350 | 0.412 кг | 5.44 кг |
| Дуже хороший pouch | 280 | 0.515 кг | 6.80 кг |
| Типовий pouch | 250 | 0.577 кг | 7.62 кг |
| Консервативно | 220 | 0.656 кг | 8.66 кг |

| Пакет | AUW | Потужність | Час | T/W |
|---|---|---|---|---|
| 5.0 кг | 11.05 кг | 1406 Вт | **62 хв** | 2.34 |
| 5.7 кг | 11.75 кг | 1532 Вт | **57 хв** | 2.20 |
| 6.4 кг | 12.45 кг | 1661 Вт | **52 хв** | 2.08 |
| 7.0 кг | 13.05 кг | 1775 Вт | 49 хв | **1.98** |
| 7.6 кг | 13.65 кг | 1891 Вт | 45 хв | **1.90** |

**Від 45 до 62 хвилин.** І межа прохідності по тязі лежить приблизно на 6.8 кг пакета.

### Дві перехресні перевірки не сходяться

При розмірах 11 × 87 × 187 мм об'єм комірки — 0.179 л:

| Показник | Значення | Стан техніки для Li-ion pouch |
|---|---|---|
| Об'ємна щільність | **806 Вт·год/л** | найкращі серійні ~700–750 |
| Питома щільність (при типовій густині pouch 2.2–2.5 кг/л) | **~350 Вт·год/кг** | найкращі серійні ~280–300 |

Обидва числа виходять за межу того, що дає серійний Li-ion. Варіанти: або розбір коду
корпусу неправильний, або паспортні 39 Ач завищені — що для комірок під ліцензованим
брендом не рідкість.

**Зважити одну комірку і зміряти штангенциркулем** — 30 секунд, і питання зникає.
Якщо комірка важить ~0.41 кг — все підтверджується і ви отримуєте 62 хв.
Якщо ~0.58 кг — це 52 хв, і конфігурація ще проходить.
Якщо важче 0.62 кг — T/W падає нижче 2.0 і payload доведеться розділяти по місіях.

### Компоновка пакета

| Варіант | Габарит |
|---|---|
| **6 × 2 стос** | **66 × 174 × 187 мм** — лягає під пластину 210 × 200 |
| 12 в стос | 132 × 87 × 187 мм — задовге по висоті |
| 2 ряди × 6 | 22 × 522 × 187 мм — не вміщується |

### Конструкція пакета — pouch вимагає іншого підходу, ніж 21700

1. **Стиснення обов'язкове.** Pouch пухне при циклюванні; без жорсткої касети з
   підтиском ~0.1–0.3 МПа комірки розшаровуються і швидко втрачають ємність.
   Потрібен жорсткий корпус (G10 або карбон) з пружинними прокладками, а не термоусадка.
2. **Виводи крихкі.** Алюміній на плюсі, нікель/мідь на мінусі. Тільки зварювання або
   гвинтовий притиск, ніякої прямої пайки потужним паяльником. Обов'язкове розвантаження
   від вібрації.
3. **Шини під 175 А.** Нікелева стрічка не годиться — мідні шини перерізом від 20 мм².
4. **12S1P не має резервування.** Одна вибула комірка — весь пакет. Для 1P критично
   підібрати комірки за ємністю і внутрішнім опором перед складанням.
5. **Балансування.** 12 балансувальних відводів, BMS або принаймні роз'єм під зарядку.

### Зарядка

39 Ач при 0.5C = 19.5 А, при 50.4 В це ~980 Вт. Junsi iCharger X12 (1100 Вт) впорається
на межі. Цикл ~2 год.

---

## 13. Повний BOM з цінами

Ціни орієнтовні, Україна, вересень 2026. Посилання ведуть на магазин або категорію —
точний SKU підтверджувати наявністю. Комірки батареї у вас вже є.

### Силова установка

| Позиція | К-сть | Ціна/од., грн | Сума, грн |
|---|---|---|---|
| [Мотор T-Motor MN6012 KV170 (або U8 Pro KV170)](https://uav.in.ua/catalog/dviguni-bezkolektorni/brand-t-motor) | 4 шт | 13 000 – 15 000 | 52 000 – 60 000 |
| [ESC 80 A HV (APD 80F3[X] / T-Motor Alpha 80A)](https://ekran.in.ua/ua/p2854951392-regulyator-motorov-esc.html) | 4 шт | 4 500 – 6 000 | 18 000 – 24 000 |
| [Гвинти 26" складані CF 2-лоп. (2 комплекти + запас)](https://modelistam.com.ua/tmotor-m-368/) | 3 пари | 5 500 | 16 500 |

### Рама

| Позиція | К-сть | Ціна/од., грн | Сума, грн |
|---|---|---|---|
| [Труба карбон Ø50×2 мм, roll-wrapped UD (промені)](https://flyshop.com.ua/truba-karbonova-kruhla/) | 2.5 м | 1 400 / м | 3 500 |
| [Пластина карбон 2 мм, 300×400 (центральні)](https://rc-store.com.ua/ramy-for-fpv) | 1 шт | 2 200 | 2 200 |
| [Пластина карбон 3 мм, 200×300 (моторні площадки)](https://rc-store.com.ua/ramy-for-fpv) | 1 шт | 1 600 | 1 600 |
| CNC різка карбону за DXF | компл. | 4 000 | 4 000 |
| Затискачі променя Ø50, складані | 4 шт | 1 200 | 4 800 |
| Стійки, дистанційники Ø8 алюміній | компл. | 800 | 800 |

### Клітка payload (вона ж шасі)

| Позиція | К-сть | Ціна/од., грн | Сума, грн |
|---|---|---|---|
| [Труба карбон Ø16×14 мм (стійки, лижі, рейки)](https://flyshop.com.ua/truba-karbonova-kruhla/) | 4 м | 400 / м | 1 600 |
| З'єднувачі/хомути Ø16 (друк PA-CF або алюміній) | 16 шт | 120 | 1 920 |
| Кронштейни під рупор і Ягі, CNC | 2 компл. | 1 250 | 2 500 |
| Лижі, накладки, кріплення | компл. | 600 | 600 |

### Авіоніка

| Позиція | К-сть | Ціна/од., грн | Сума, грн |
|---|---|---|---|
| [Політний контролер Matek H743-SLIM V3](https://www.mini-tech.com.ua/ua/matek_h743_slim) | 1 шт | 4 450 – 5 800 | 4 450 – 5 800 |
| [GPS Matek M10Q-5883 (щогла 150–200 мм)](https://uadron.com/ua/p2768547877-polyotnyj-kontroller-matek.html) | 1 шт | 1 800 – 2 500 | 1 800 – 2 500 |
| [Power module HV 12S (Mauch PL-200 / Holybro PM02D)](https://dron-shop.com.ua/fpv/flight_controllers/) | 1 шт | 2 500 – 3 500 | 2 500 – 3 500 |
| Демпфери м'які 400 Н/м + платформа з масою 200 г | компл. | 900 | 900 |
| Companion Raspberry Pi Zero 2 W + microSD + корпус | 1 шт | 1 800 | 1 800 |
| microSD 32 ГБ (логи для FFT) | 1 шт | 300 | 300 |

### Зв'язок

| Позиція | К-сть | Ціна/од., грн | Сума, грн |
|---|---|---|---|
| [Starlink Mini (Roam), комплект](https://epicentrk.ua/ua/shop/mplc-komplekt-internetu-starlink-v3-gen3-mini-roam-bez-priv-azki-do-misca-19520506-1ef57d5d-7784-6ccc-967f-2342a190bb6b.html) | 1 шт | 20 490 | 20 490 |
| DC-DC buck 24 В / 150 Вт (Starlink) | 1 шт | 1 800 | 1 800 |
| DC-DC buck 12 В / 150 Вт (payload, по піку) | 1 шт | 1 800 | 1 800 |
| [DJI O4 Air Unit](https://dron-shop.com.ua/fpv/) | 1 шт | 12 000 | 12 000 |
| [Приймач ELRS 2.4 ГГц Radiomaster RP3 V2 Nano diversity](https://prom.ua/ua/m-7604484336729232608-priemnik-radiomaster-diversity.html) | 1 шт | 1 234 | 1 234 |
| [ELRS TX модуль 2.4 ГГц](https://uav.in.ua/products/prijmach-rx-elrs-24ghz-true-diversity-receiver-rp4td-radiomaster) | 1 шт | 2 500 | 2 500 |

### Батарея (комірки вже є)

| Позиція | К-сть | Ціна/од., грн | Сума, грн |
|---|---|---|---|
| Касета G10/карбон з підтиском 0.1–0.3 МПа | 1 шт | 2 500 | 2 500 |
| Мідна шина 20 мм² + наконечники | компл. | 1 200 | 1 200 |
| Балансувальний джгут 12S + роз'єм | 1 шт | 600 | 600 |
| Роз'єм AS150 + XT150, пара | 1 компл. | 800 | 800 |

### Метиз і дрібниця

| Позиція | К-сть | Ціна/од., грн | Сума, грн |
|---|---|---|---|
| M4×12 нерж. — кріплення моторів | 16 шт | — | — |
| M4×30 нерж. — затискачі променів до пластин | 16 шт | — | — |
| M4×16 нерж. — клітка, кронштейни антен, Starlink | 24 шт | — | — |
| M3×35 — стійки між пластинами | 8 шт | — | — |
| M3×8 — дрібне кріплення | 40 шт | — | — |
| Гайки самоконтрящі M3/M4 | 80 шт | — | — |
| Шайби, Loctite 243 | компл. | — | — |
| МЕТИЗ КОМПЛЕКТОМ |  | — | 1 500 |
| Силовий кабель 10 AWG | 3 м | 300 / м | 900 |
| Термоусадка, стяжки, фери́ти ×6 | компл. | 800 | 800 |

### Разом

| | грн |
|---|---|
| **Апарат повністю** | ** 169894 –  186944** |
| Зарядка Junsi iCharger X12 (якщо немає) | 12 000 |
| Апаратура RadioMaster TX16S / Boxer | 8 000 – 14 000 |
| Окуляри або монітор | 18 000 – 25 000 |

Не входить: сам ретранслятор, рупорна антена, Ягі — це ваше залізо.
Їх маса підставлена оцінкою (600 / 400 / 500 г) і потребує уточнення.

---

## 14. Політний контролер: чому не F722

**F722 не підійде принципово, це не питання смаку.**

STM32F722 має **512 КБ флешу**. ArduCopter 4.5+ потребує мінімум 1 МБ, а для повного
набору функцій — 2 МБ. На F722 ArduPilot просто не збирається. Залишається Betaflight
або INAV.

Для 12-кілограмового апарата з 50-хвилинним автономним висінням INAV недостатньо:
немає EKF3, слабша логіка failsafe, немає оцінки вітру, обмежене логування — а саме лог
потрібен, щоб зняти FFT і налаштувати notch під ваші гвинти.

### Потрібно щонайменше H743

| | Matek H743-SLIM V3 | Pixhawk 6C | Cube Orange+ |
|---|---|---|---|
| Флеш | 2 МБ | 2 МБ | 2 МБ |
| Ізоляція IMU | немає, робити зовні | немає | **вбудована** |
| Підігрів IMU | немає | немає | **є** |
| Ціна | 4 450 – 5 800 грн | ~11 000 грн | ~25 000 грн |

**Рекомендація: Matek H743-SLIM V3** + зовнішня вібророзв'язка (§15).
Cube Orange+ знімає питання ізоляції і температурного дрейфу IMU, що на 50-хвилинному
висінні на 1500 м має значення, але коштує вп'ятеро дорожче.

### Розподіл UART (H743-SLIM має 7)

| UART | Призначення |
|---|---|
| 1 | GPS M10Q |
| 2 | ELRS 2.4 ГГц RX (CRSF) |
| 3 | DJI O4 Air Unit |
| 4 | Companion Pi → MAVLink через Starlink |
| 5 | Телеметрія ESC |
| 6 | Телеметрія payload / ретранслятора |
| 7 | Резерв (наземна телеметрія) |

**MAVLink через Starlink потребує companion-комп'ютера.** Starlink дає Ethernet/WiFi,
контролер — UART. Міст: Raspberry Pi Zero 2 W з `mavlink-router`. Це окремий вузол,
якого не було в попередніх розділах — 50 г і 1 800 грн.

---

## 15. Вібророзв'язка — так, і стандартна НЕ працює

При AUW 12.6 кг і 26" гвинтах: **ротор 46.6 Гц, лопатева 93.2 Гц.**

Ізоляція починає працювати при `f_збудження / f_власна > 1.41`, добра — при `> 3`.
Тобто власна частота підвісу має бути **нижче 15.5 Гц**.

| Варіант монтажу | f власна | f_рот / f_вл | Результат |
|---|---|---|---|
| FPV силіконові кульки, тільки FC (40 г) | 50.3 Гц | 0.93 | **ПІДСИЛЕННЯ** |
| Те саме + платформа 100 г | 31.8 Гц | 1.46 | слабка |
| Те саме + платформа 200 г | 22.5 Гц | 2.07 | слабка |
| **М'які демпфери 400 Н/м × 4 + платформа 200 г** | **14.2 Гц** | **3.27** | **OK** |
| М'які демпфери 400 Н/м × 4 + платформа 250 г | 12.7 Гц | 3.66 | OK |

**Звичайні FPV-кульки на цьому апараті не гасять вібрацію, а підсилюють її** — їхня
власна частота лягає майже точно на частоту обертання гвинта.

### Конструкція підвісу

1. Платформа з карбону 2 мм, **дозавантажена до 200–250 г** латунню або свинцем.
   Мала маса тут шкідлива: чим легша платформа, тим вища власна частота.
2. **Чотири м'які демпфери ~400 Н/м** — великі силіконові втулки або гелеві,
   не жорсткі FPV-кульки.
3. Проводка до платформи — **тонка і петлями**. Жорсткий джгут шунтує підвіс
   і зводить усю розв'язку нанівець.
4. Після першого висіння: `INS_LOG_BAT_MASK=1`, зняти FFT, переконатись що
   піки на 46.6 і 93.2 Гц задавлені, `VIBE` нижче 15 м/с².

---

## 16. Клітка payload — вона ж шасі

Рупор 283 мм завдовжки не вміщується під батареєю при ніжках 300 мм.
Рішення: **кронштейн payload виконує функцію шасі.**

### Вертикальна компоновка

| Рівень | z, мм |
|---|---|
| Площина гвинтів | 0 |
| Нижня пластина | −50 |
| Низ батареї (66 мм) | −116 |
| Рейка payload | −140 |
| Кінець Ягі 5 ел. (266 мм) | −406 |
| Апертура рупора (283 мм) | −423 |
| Лижі | −450 |

Висота клітки від нижньої пластини — **400 мм**, просвіт під рупором 27 мм.

**Ягі береться 5-елементний, не 6-елементний.** 6 елементів це бум 366 мм, і клітка
виростає до 500 мм. Втрата 1 dB проти 100 мм висоти і 50 г — обмін вигідний.

### Горизонтальна компоновка

Рупор 226 мм + Ягі 173 мм + зазор 40 мм = **439 мм**, тобто ±220 мм від центру.

Гвинти 26" на базі 1100 мм досягають всередину до 550 − 330 = **220 мм**.
**Клітка рівно вписується в тіньову зону під центром, поза диском гвинтів** — втрати
на перекриття струменя мінімальні.

Балансування: рупор (600 г) і Ягі (400 г) по різні боки, різниця 200 г компенсується
положенням блока ретранслятора. Зміщення ЦМ по горизонталі — не більше 20 мм.

### Склад клітки

| Вузол | Маса |
|---|---|
| 4 стійки Ø16×14, 400 мм | 117 г |
| 2 лижі Ø16, 500 мм | 73 г |
| 2 поперечні рейки Ø16, 450 мм | 66 г |
| 8 хомутів/кутників | 96 г |
| Кронштейни антен | 80 г |
| Метиз | 60 г |
| **Разом** | **492 г** |

Замінює звичайне шасі (206 г), тож чистий приріст +286 г.

---

## 17. Труба променя — кругла Ø50 краща за квадрат

Квадратний карбон 40×40 в Україні складно дістати: у продажу переважно сталь,
карбон — під замовлення. Кругла труба є на складі.

Плече 455 мм, лопатева 93.2 Гц:

| Переріз | I, мм⁴ | кг/м | f₁ | Запас |
|---|---|---|---|---|
| Квадрат 40×40×2 | 73 365 | 0.471 | 126 Гц | 1.35 |
| Кругла Ø40×2 | 43 216 | 0.370 | 98 Гц | **1.05 — не годиться** |
| **Кругла Ø50×2** | **87 010** | **0.467** | **137 Гц** | **1.47** |
| Кругла Ø50×1.5 | 67 265 | 0.354 | 122 Гц | 1.31 |

**Ø50×2 краща за квадрат 40×40×2 за всіма параметрами**: та сама маса, на 9 % більший
запас, і її реально купити.

Ø50×1.5 економить ще **241 г** (≈ +3 хв польоту), але під затискачем 1.5 мм стінку
можна зім'яти — потрібна внутрішня втулка або широкий хомут від 40 мм.

Ø40 круглу не брати: запас 1.05 означає роботу на резонансі.

---

## 18. Оновлена маса і час

| Позиція | Маса |
|---|---|
| Планер (мотори, ESC, гвинти, рама Ø50×2, база 1100) | 3.870 кг |
| Starlink Mini комплект | 1.320 кг |
| Рупор 3.3 ГГц + кронштейн *(оцінка)* | 0.600 кг |
| Ягі 900 МГц 5 ел. + кронштейн *(оцінка)* | 0.400 кг |
| Клітка payload / шасі | 0.492 кг |
| Блок ретранслятора + DC-DC *(оцінка)* | 0.500 кг |
| Платформа FC з демпферами і масою | 0.150 кг |
| Companion Pi | 0.050 кг |
| Фідери, проводка, кріплення | 0.250 кг |
| **Суха** | **7.632 кг** |

| Пакет | AUW | Потужність | Час | T/W |
|---|---|---|---|---|
| **5.0 кг** | **12.63 кг** | **1700 Вт** | **51 хв** | **2.05** |
| 5.7 кг | 13.33 кг | 1833 Вт | 47 хв | **1.94** |
| 6.4 кг | 14.03 кг | 1971 Вт | 43 хв | **1.85** |

**Конфігурація на межі.** T/W 2.05 при пакеті 5.0 кг — це найкращий випадок.
Якщо блок ретранслятора важчий за ~600 г або пакет важчий за ~5.2 кг, T/W падає
нижче 2.0 і payload доведеться розділяти по місіях: Starlink **або** антени.

Перехід на пласкі антени (§10.2) повернув би ~430 г і 4 хв, але це ваше рішення —
воно коштує 1.5 dB на 900 МГц.

---

## 19. Pixhawk 6X + CM4 та камера SIYI ZR10 — планер виріс

### 19.1 Авіоніка: Pixhawk RPi CM4 Baseboard

Плата приймає модуль Pixhawk 6X (стандарт PAB) і Raspberry Pi CM4 на одній основі.

| Вузол | Маса |
|---|---|
| Pixhawk RPi CM4 Baseboard | 110 г |
| Модуль Pixhawk 6X (PAB) | 50 г |
| Raspberry Pi CM4 4 ГБ | 25 г |
| Радіатор CM4 | 30 г |
| **Разом** | **215 г** |

**Замінює:** Matek H743 (15 г) + окремий companion Pi Zero (50 г) + баласт
вібро-платформи (110 г). Чистий приріст — лише **+60 г**.

Що дає Pixhawk 6X поверх H743:

| | H743-SLIM | Pixhawk 6X |
|---|---|---|
| IMU | 2, без резерву | **3, на окремих шинах з окремим живленням** |
| Ізоляція IMU | зовнішня | **вбудована** (плюс зовнішня) |
| Підігрів IMU | немає | **є** |
| Барометр | 1 | 2 |
| Companion | окремо | **CM4 на платі, Ethernet для Starlink** |

Підігрів IMU для нашої задачі не дрібниця: за 50 хв на 1500 м температура падає
на 8–10 °C, а дрейф гіроскопа по температурі — пряма причина «повзання» позиції
в Loiter. Тут він знімається апаратно.

**Вібророзв'язка спростилась.** Стек 215 г достатньо важкий сам по собі:

| Варіант | f власна | Запас |
|---|---|---|
| H743 + платформа з баластом 250 г | 12.7 Гц | 3.66× |
| **Стек Pixhawk+CM4 215 г + тека 40 г** | **12.6 Гц** | **3.70×** |

Баласт більше не потрібен — ті самі чотири м'які демпфери 400 Н/м, тека з карбону 2 мм.

**Живлення:** Pixhawk 6X ~3 Вт, CM4 3–7 Вт → авіоніка з 25 Вт зростає до **35 Вт**.

### 19.2 SIYI ZR10 — і чому 26" більше не проходить

| Джерело | Маса | Споживання |
|---|---|---|
| Специфікація в пошуку | 381 г | 3 Вт |
| Типова для 3-осьового підвісу з 10× оптикою | ~920 г | ~15 Вт |

**Дані суперечливі — зважити перед фіналом.** Розрахунок нижче на обидва випадки.

| Конфігурація | AUW | Потужність | Час | T/W |
|---|---|---|---|---|
| ZR10 381 г, 26", база 1100 | 13.24 кг | 1823 Вт | 47 хв | **1.96** |
| **ZR10 381 г, 28", база 1150** | **13.29 кг** | **1710 Вт** | **50 хв** | **2.21** |
| ZR10 920 г, 26", база 1100 | 13.78 кг | 1940 Вт | 44 хв | **1.88** |
| **ZR10 920 г, 28", база 1150** | **13.83 кг** | **1820 Вт** | **47 хв** | **2.12** |

**26" не проходить по тязі в жодному з варіантів.** Перехід на 28" і базу 1150
відновлює T/W і водночас **додає 3 хв польоту** — більший диск компенсує свою масу
з надлишком.

### 19.3 «День + ніч» — ZR10 цього не дає в повному обсязі

ZR10 має **starlight-сенсор**: добре бачить у сутінках і при слабкому світлі.
Це **не тепловізор**. У повній темряві, через дим, туман або листя він не працює.

| Камера | День | Ніч | Маса |
|---|---|---|---|
| **ZR10** | 2K, 10× оптика | starlight (слабке світло) | 381–920 г |
| ZT6 | є | **тепловізор** | ~380 г |
| ZT30 | 4K, 30× оптика | **тепловізор + лазерний далекомір** | ~880 г |

Якщо під «ніч» мається на увазі тепловізійний канал — потрібен ZT6 або ZT30,
а не ZR10. ZT6 при цьому легший за ZR10 у важкому трактуванні.

### 19.4 Конфлікт полів зору — головне в компоновці

Рупор 226×226 дивиться **вниз по центру**. ZR10 — тривісний, тангаж ±90° — потребує
**нижньої півсфери**. Обидва в центрі стояти не можуть.

Рішення: рознести по осі X.

| Вузол | x, мм | y, мм | Маса |
|---|---|---|---|
| ZR10 | +200 (ніс) | 0 | 0.53 кг |
| Блок ретранслятора | +100 | +160 | 0.50 кг |
| Рупор 3.3 ГГц | −140 (корма) | 0 | 0.60 кг |
| Ягі 900 МГц | −140 | −200 | 0.40 кг |

Моменти: по X `0.53×200 + 0.50×100 − 0.60×140 − 0.40×140 = +16 кг·мм` → зміщення ЦМ
**+8 мм**. По Y ретранслятор компенсує Ягі. Обидва в межах допустимих 20 мм.

### 19.5 Оновлена геометрія під 28"

| Параметр | База 1150 |
|---|---|
| Мотор–мотор | 813 мм |
| Зазор між гвинтами | 102 мм (14 % D) |
| Внутрішній досяг гвинта | 219 мм |
| Starlink (поворот 45°), запас до диска | 103 мм |
| Щогла GPS на осі Y, R=230, запас | 90 мм |

### 19.6 Вертикальна компоновка

| Рівень | z, мм |
|---|---|
| Площина гвинтів | 0 |
| Верх Starlink (демпфери 5 мм) | −6 |
| Верхня пластина | −55 |
| **Авіоніка між пластинами** | **−55…−105** |
| Вісь променя Ø50 | −80 |
| Нижня пластина | −105 |
| Низ батареї (66 мм) | −171 |
| Рейка payload | −195 |
| Кінець Ягі 5 ел. | −461 |
| Апертура рупора | −478 |
| Лижі | −505 |

**Загальна висота апарата — 499 мм.**

Авіоніка ставиться **між пластинами**, у центральній зоні: промені Ø50 займають лише
чотири радіальні смуги по 45°, центр вільний. Просвіт 50 мм, плата 110×60×30 мм
вміщується з місцем під демпфери. Це економить 50 мм загальної висоти проти
підвісної теки.

Креслення: `ga-drawing.svg`.

---

## 20. Живлення і дані

Схема: `system-diagram.svg`

### 20.1 Струми

| Режим | Струм | Від ліміту 175 А |
|---|---|---|
| Висіння, всього | 38.5 А (0.99C) | 22 % |
| Висіння, на мотор | 9.0 А | — |
| Повний газ, всього | 171 А (4.4C) | **98 %** |
| Повний газ, на мотор | 42.8 А | ESC 80 А: 1.9× |

### 20.2 Перерізи і втрати

| Ділянка | Переріз | Довжина | Струм | Спад | Втрати |
|---|---|---|---|---|---|
| Батарея → PDB | 8 AWG (8.37 мм²) | 0.25 м | 171 А | 0.18 В | 30 Вт |
| PDB → ESC (промінь) | 12 AWG (3.31 мм²) | 0.55 м | 42.8 А | 0.25 В | 10.5 Вт |
| Buck 12 В → ретранслятор | 14 AWG | 0.50 м | 12.5 А | 0.10 В | 1.3 Вт |
| Buck 24 В → Starlink | 16 AWG | 0.40 м | 4.2 А | 0.04 В | 0.2 Вт |
| Buck 12 В → ZR10 | 18 AWG | 0.45 м | 1.3 А | 0.03 В | — |

Втрати наведені для **повного газу**; у висінні вони падають у ~20 разів (квадрат струму),
тобто в крейсерському режимі на проводах втрачається менше 2 Вт сумарно.

### 20.3 Датчик струму — PM02D не підходить

Потрібен вимір до **171 А**. Holybro PM02D розрахований на 60 А.

**Mauch HS-200-HV** — холлівський, 200 А, без шунта в силовому колі, тобто без
додаткових втрат і нагріву. Плюс Mauch BEC 5.3 В на POWER1 Pixhawk.

Pixhawk 6X має **два входи живлення**. POWER2 живиться від окремого резервного BEC:
на апараті за 13 кг з payload на кілька тисяч доларів дублювання живлення автопілота
коштує 40 г і окупається одним випадком.

### 20.4 Чотири шини, і ZR10 на окремій

| Шина | Напруга | Середнє | Пік |
|---|---|---|---|
| ESC | 36–50.4 В прямо | 1590 Вт | 7600 Вт |
| Starlink | 24 В / 150 Вт | 39 Вт | 100 Вт |
| Ретранслятор RF | 12 В / 150 Вт | 42 Вт | 150 Вт |
| **SIYI ZR10** | **12 В / 50 Вт, окремо** | 15 Вт | 25 Вт |

**Камеру не можна вішати на шину ретранслятора.** RF-підсилювач має пік-фактор 3–5×;
кожна передача просаджуватиме напругу, а підвіс на просадці смикається. Це
безпосередньо псує те, заради чого купується ZR10 — стабільну картинку.

Конденсатори: 220 мкФ / 63 В low-ESR біля **кожного** ESC (довгі промені), банк
2×680 мкФ / 63 В на PDB, фери́т на вході й виході кожного buck.

### 20.5 Ethernet — ще один пропущений вузол

CM4 має **один** порт Ethernet. Абонентів троє: Starlink, ZR10 і Ethernet самого
Pixhawk 6X.

**Потрібен комутатор на 4 порти** — ~15 г, 1.5 Вт. У BOM його не було.

Мережа: Pixhawk 6X ↔ CM4 з'єднані **на платі baseboard**, зовнішнього дроту між ними
немає — це й є сенс цієї плати. CM4 крутить `mavlink-router` і ретрансляцію відео.

### 20.6 Розподіл UART

| Порт | Призначення |
|---|---|
| GPS1 + I2C | GPS M9N / F9P на щоглі 200 мм |
| TELEM1 | ELRS 2.4 ГГц RX (CRSF) |
| TELEM3 | Телеметрія ретранслятора |
| UART4 | Телеметрія ESC (bidirectional DShot) |
| — | DJI O4 Air Unit |
| внутрішній | CM4 (на платі) |

### 20.7 Радіочастотний план — одна нова правка

| Система | Частота | Примітка |
|---|---|---|
| GPS L1 | 1575 МГц | щогла 200 мм, окремо від buck-ів |
| Ягі payload | 900 МГц | через нього ELRS перенесено з 868 |
| ELRS керування | 2.4 ГГц | |
| Рупор payload | 3.3 ГГц | |
| **DJI O4 відео** | **5.8 ГГц** | **примусово лише 5.8** |
| Starlink | 10.7–14.5 ГГц | |

**O4 треба заблокувати на 5.8 ГГц.** За замовчуванням він працює і на 2.4, а там тепер
сидить канал керування. Два власні передавачі в одній смузі на одному планері — та сама
помилка, від якої ми пішли з 868 МГц, тільки на іншій частоті.

### 20.8 Два незалежні канали і failsafe

| | Канал | Характеристика |
|---|---|---|
| Керування 1 | ELRS 2.4 ГГц | пряма лінія, ~15–30 км, затримка ~10 мс |
| Керування 2 | MAVLink через Starlink | без обмеження дальності, 50–150 мс |
| Відео 1 | DJI O4 5.8 ГГц | зліт і посадка, низька затримка |
| Відео 2 | ZR10 → Starlink | місія, без обмеження дальності |

**Ієрархія:** втрата ELRS → продовжувати по Starlink · втрата обох → RTL ·
втрата GPS → Loiter по оптичному потоку.

Саме заради цього Starlink перестає бути «опцією»: він єдиний дає другий незалежний
канал керування, а на 13-кілограмовому апараті за межею прямої видимості один канал —
це одна точка відмови.

### 20.9 Доповнення до BOM

| Позиція | Ціна, грн |
|---|---|
| Mauch HS-200-HV + BEC (замість PM02D) | 6 500 |
| Резервний BEC 5.3 В | 900 |
| Комутатор Ethernet 4 порти | 1 500 |
| Конденсатори 220 мкФ/63 В ×6, 680 мкФ/63 В ×2 | 800 |
| Кабель 8 AWG, 12 AWG, наконечники | 1 400 |
| **Разом** | **+11 100** |

---

## 21. Ескізний комплект PDF і що він виправив

Файл: `frame-sketch.pdf`, 4 аркуші A3 у масштабі, з позиційними виносками і специфікацією.
Генератор: `tools/make_sketch.py` — після зважування комірки, ZR10 і ретранслятора
ескіз перебудовується однією командою. Замінює `ga-drawing.svg` і `frame-24in-layout.svg`.

| Аркуш | Зміст | Масштаб |
|---|---|---|
| 1 | Вид зверху, порядок моторів ArduCopter | 1:6 |
| 2 | Вид збоку, рівні z | 1:5 |
| 3 | Вид спереду, специфікація (16 позицій) | 1:5 |
| 4 | План payload, центральна пластина з отворами | 1:4 / 1:2 |

Креслення в масштабі виявило три речі, яких не було видно в розрахунках:

**1. Ягі стояв на місці задньої ніжки.** При x = −140 задня ліва ніжка клітки проходила
крізь елементи Ягі. Ягі перенесено на **x = −40**: до ніжки 89 мм, більше λ/4 = 83 мм,
тож карбон його не розстроює.

**2. Центральна пластина 210×200 замала для Ø50.** Болти затискачів виходили за край.
Пластина стала **250×250** з фасками (≈ +80 г на дві), затискач 4×M4, крок 40 × 64.
У генераторі є автоматична перевірка: край, перемички між отворами, отвори під затискачами.

**3. Центр мас.** Після переносу Ягі момент payload по x = +56 кг·мм. Компенсується
зсувом касети батареї на **11 мм назад**; по y +17 кг·мм = 1.3 мм, у допуску.

Також виправлено: у попередньому ескізі рупор і Ягі стояли з зазором 0.5 мм по борту
(тепер рупор y = +25, Ягі y = −195, зазор 20 мм), а вид збоку з носом праворуч — це вид
з **правого** борту, не з лівого.

---

## 22. DXF центральних пластин

Файли: `cnc/plate_top.dxf`, `cnc/plate_bottom.dxf`, завдання для цеху — `cnc/README.md`.

Геометрія пластин тепер в одному місці — `tools/plate_geometry.py`. З неї будуються
і DXF, і аркуш 4 PDF-ескізу, тож розбіжність між кресленням і файлом на різку неможлива.

| | Верхня | Нижня |
|---|---|---|
| Отворів | 26 | 36 |
| Пази 40×12 | 2 | 2 |
| Центральний виріз | 80×80 R10 | 70×50 R10 |
| Маса, CF 2 мм | 168 г | 177 г |

**Орієнтир:** півкруглий виріз R2.5 на передній кромці — ніс. Фізичний, тож цех не зріже
його як гравіювання.

Кожен файл перед записом проходить: відстань до кромки ≥ 1.5·d, перемички ≥ 6 мм,
нічого під затискачами, пластина цілісна. Після запису DXF читається назад: аудит,
кількість отворів, габарит і **площа кожного контуру проти еталону** — так ловиться
дуга, вигнута не в той бік, чого на око в мініатюрі не видно.

### Маса пластин виявилась більшою, ніж закладено

Раніше в бюджеті стояло 150 г на обидві (пластина 210×200 з 35 % полегшення).
Реально **345 г**: пластина стала 250×250, а полегшити її майже нема куди — периметр
зайнятий затискачами, стійками, кронштейнами і кріпленням ніжок.

| | AUW | Час | T/W |
|---|---|---|---|
| Було | 13.29 кг | 50.5 хв | 2.21 |
| **Стало** | **13.48 кг** | **49.4 хв** | **2.18** |

Мінус хвилина. Верхню пластину можна взяти 1.5 мм (−42 г), але вона несе затискачі
променів — лишаю 2 мм.

### Ще не накреслено

Кронштейн Starlink, кронштейн щогли GPS, тека Pixhawk на демпферах, касета батареї,
вузли кріплення ніжок. Для теки потрібна розмітка отворів плати Holybro RPi CM4
Baseboard — її я не маю перевіреної, тому на пластині лише 4 отвори під демпфери,
а сама плата кріпиться до теки.

---

## 23. Клітка payload — креслення, і чому змінилась компоновка

Файли: `cage-drawings.pdf` (3 аркуші A3), `cnc/cage_horn.dxf`, `cnc/cage_zr10.dxf`, `cnc/cage_tray.dxf`.
Геометрія: `tools/cage_geometry.py`. З неї тепер будується і основний ескіз `frame-sketch.pdf`.

### 23.1 Помилка попередньої компоновки

Коли клітку промоделював у 3D, виявилось: **елементи Ягі стояли за 42 мм від металевого рупора.**
У §21 я називав зазор 20 мм прийнятним. Механічно так і є, але для антени 900 МГц
провідник ближче λ/4 = 83 мм збиває налаштування. Ягі з'їхав би з частоти.

Payload перекомпоновано:

| Вузол | Було (x, y) | Стало (x, y) |
|---|---|---|
| ZR10 | +200, 0 | +200, 0 |
| Рупор | −140, +25 | **−185, 0** |
| Ягі | −40, −195 | **+30, −130** |
| Ретранслятор | +100, +160 | **+20, +110** |

### 23.2 Відстані від Ягі до провідників

| Що | Відстань | |
|---|---|---|
| батарея | 56 мм | **нижче λ/4** |
| лижі CF | 82 мм | **нижче λ/4** |
| ніжки CF | 84 мм | OK |
| ретранслятор | 94 мм | OK |
| рупор | 100 мм | OK |
| ZR10 | 103 мм | OK |
| нижня пластина CF | 124 мм | OK |

Лишаються дві точки ближче λ/4. **Батарея** стоїть над рефлектором, а це найменш чутливий бік
Ягі: антена дивиться вниз, батарея позаду неї. **Лижа** на 82 мм — практично на межі.
Тому КСХВ Ягі треба виміряти на зібраному апараті; якщо з'їде, лижу можна замінити на G10.

### 23.3 Матеріал: поруч з Ягі — тільки склопластик

Рейки, поперечки й лоток ретранслятора — **G10 (FR4), намотана трубка**: радіопрозорі.
Карбонова рейка проходила б за 12 мм від кінців елементів.
Ніжки й лижі — карбон: вони несуть посадку і стоять від Ягі на 84 і 82 мм.
Друковані вузли біля антени (J4–J7) — PETG без вуглецевого наповнювача.

### 23.4 Труби

| Поз. | Деталь | Матеріал | L різу | К-сть | Маса |
|---|---|---|---|---|---|
| Т1 | Ніжка | карбон | 457 | 4 | 134 г |
| Т2 | Лижа | карбон | 600 | 2 | 88 г |
| Т3 | Рейка | склопластик G10 | 560 | 2 | 98 г |
| Т4 | Поперечка X1 | склопластик G10 | 335 | 1 | 29 г |
| Т5 | Поперечка X2 | склопластик G10 | 270 | 1 | 24 г |

Ніжка: між точками вузлів 473.0 мм, розвал 32.0° вбік і 5.0° вперед/назад
(від вертикалі 32.3°). Гнізда J1 і J3 друкуються під цей складений кут.

### 23.5 Вузли

| Поз. | Назва | Матеріал | К-сть | Опис |
|---|---|---|---|---|
| J1 | Кронштейн ніжки | PA-CF | 4 | до нижньої пластини 2×M4 крок 20; гніздо Ø16 |
| J2 | Хрест ніжка–рейка | PA-CF | 4 | осі зі зсувом 18 мм; ніжка під кутом до рейки |
| J3 | Т-вузол ніжка–лижа | PA-CF | 4 | охоплює лижу; гніздо ніжки |
| J4 | Хрест поперечка–рейка | PETG | 4 | 90°, зсув осей 16 мм, поперечка під рейкою |
| J5 | Сідло Ø16 | PETG | 12 | 2×M3 крок 28: 4 рупор, 4 ZR10, 4 лоток |
| J6 | Затискач бума Ягі | PETG | 1 | на X1; без вуглецевого наповнювача |
| J7 | Заглушка лижі | PETG | 4 |  |

Осі в хрестах не перетинаються. Труби проходять одна повз одну, хомут тримає обидві.
Рейки для цього зсунуті на 18 мм всередину від ніжок, а поперечки йдуть на 16 мм нижче рейок.

### 23.6 Плити

| Поз. | Плита | Матеріал | Маса | DXF |
|---|---|---|---|---|
| П1 | Плита рупора | CF 3 мм | 72 г | `cnc/cage_horn.dxf` |
| П2 | Плита ZR10 | CF 2 мм | 74 г | `cnc/cage_zr10.dxf` |
| П3 | Лоток ретранслятора | G10 2 мм | 83 г | `cnc/cage_tray.dxf` |

Кожна плита проходить ту саму перевірку, що й центральні: кромка, перемички, цілісність,
а після запису площа контурів у DXF проти еталону.
Отвори під фланець рупора, кріплення SIYI і короб ретранслятора **розмічаються по місцю**:
перевіреної розмітки цих виробів у мене немає, а вгадувати отвори для CNC не можна.

### 23.7 Маса — клітка вийшла важчою за бюджет

| | |
|---|---|
| Труби | 372 г |
| Вузли | 208 г |
| Плити П1–П3 | 229 г |
| Кріпіж | 40 г |
| **Разом** | **848 г** (у бюджеті було 492 г) |

| | AUW | Висіння на 1500 м | T/W |
|---|---|---|---|
| До креслення клітки | 13.48 кг | 49.4 хв | 2.18 |
| **Після** | **13.84 кг** | **47.5 хв** | **2.12** |

Узято гірший випадок: частина різниці, ймовірно, вже сиділа в оцінках «рупор + кронштейн»
і «Ягі + кронштейн». Реальна цифра з'явиться після зважування рупора, Ягі й ретранслятора.

### 23.8 Інші наслідки

- Висота апарата: **517 мм** (було 499). Лижі опустились на 18 мм, щоб Ягі мав просвіт 34 мм.
- Зсув касети батареї для балансування: **3 мм** назад (було 11).
- Мінімальний механічний зазор у клітці: 9 мм (рейка ↔ ZR10).

---

## 24. Зони встановлення замість конкретного навісного

Навісне обладнання ви рахуєте самі, тож конструкція тепер описує **зони**: об'єми, куди
гарантовано нічого з рами не залазить, і інтерфейс кріплення в кожній.
Розділ 23 з конкретними рупором, Ягі, ZR10 і ретранслятором втратив силу. Висновки про
радіочастотні відстані з нього перенесено в загальні правила нижче.

Файли: `cage-drawings.pdf` (5 аркушів: зони, бюджет, складальне, труби й вузли, монтажні плити),
`cnc/cage_plate_center.dxf`, `cnc/cage_plate_side.dxf`. Основний ескіз `frame-sketch.pdf` теж показує зони.

### 24.1 Зони

| | Зона | Д × Ш × В, мм | Кріплення | Примітка |
|---|---|---|---|---|
| **A** | Носова | 123 × 544 × 288 | рейки + поперечки | огляд вперед і вниз вільний; частково під дисками гвинтів |
| **B** | Центральна | 208 × 544 × 288 | рейки + поперечки | найбільша; важке ставити ближче до центру |
| **C** | Кормова | 123 × 544 × 288 | рейки + поперечки | огляд назад і вниз вільний; частково під дисками |
| **D** | Коридори ніжок | 63 × 150 × 288 | лише рейки | між ніжками; дзеркально x −167…−104; для довгих виробів |
| **T** | Верхня | 390 × 390 × 44 | 4×M4 на верхній пластині | коло R195 у тіні гвинтів; прямокутне — з поворотом 45° |
| **V** | Відсік авіоніки | 112 × 112 × 40 | демпфери | між пластинами; зайнятий Pixhawk 6X + CM4 |

Зони A–D лежать під рейками (z від −205 до −493). Кожна перевірена в 3D: до ніжок, лиж
і касети батареї (в усьому її ході) — не менше 10 мм, до землі — 30 мм.

### 24.2 Інтерфейс кріплення

- **Рейки** G10 Ø16 на y ±72, z −195, x −280…+280. Сідла J5 (2×M3, крок 28) — у будь-якому місці.
- **Поперечки** G10 Ø16 під рейками, де потрібно, **крім коридорів ніжок** (x ±104…167).
- **П1**, плита між рейками, CF 2 мм, 190 × 130, і **П2**, бортова, G10 2 мм, 150 × 150.
  На обох сітка M3 з кроком 20: під будь-який виріб без переробки плити.
- **Зона T** — 4×M4 на верхній пластині.

### 24.3 Бюджет навісного

Апарат без навісного **4.95 кг** + батарея 5.0 кг = **9.95 кг**.
Межа навісного за T/W ≥ 2.0 на 1500 м — **4.74 кг** (разом з кронштейнами, плитами, фідерами).

| Навісне, кг | AUW | T/W | 0 Вт | 50 Вт | 100 Вт | 200 Вт |
|---|---|---|---|---|---|---|
| 0.0 | 9.9 | 2.95 | 83 | 79 | 75 | 69 |
| 0.5 | 10.4 | 2.81 | 77 | 74 | 71 | 65 |
| 1.0 | 10.9 | 2.68 | 72 | 69 | 66 | 61 |
| 1.5 | 11.4 | 2.57 | 67 | 64 | 62 | 58 |
| 2.0 | 11.9 | 2.46 | 63 | 60 | 58 | 54 |
| 2.5 | 12.4 | 2.36 | 59 | 57 | 55 | 52 |
| 3.0 | 12.9 | 2.27 | 55 | 54 | 52 | 49 |
| 3.5 | 13.4 | 2.18 | 52 | 51 | 49 | 46 |
| 4.0 | 13.9 | 2.11 | 49 | 48 | 47 | 44 |
| 4.5 | 14.4 | 2.03 | 47 | 45 | 44 | 42 |

Час у хвилинах висіння на 1500 м. Споживання — середнє з батареї.
Для орієнтиру: попередній набір (Starlink, ZR10, рупор, Ягі, ретранслятор) — 3.6 кг і ~96 Вт → 49 хв.

### 24.4 Центр мас

`Mx = Σ mᵢ·xᵢ`, `My = Σ mᵢ·yᵢ` (кг·мм; x — вперед, y — праворуч від центру).

- **Касета батареї тепер у пазах ±15 мм** (нижня пластина, DXF оновлено) і компенсує по x до ±75 кг·мм.
  Зсув касети: `Δx = −Mx / 5`.
- По y компенсації немає: навісне розкладати симетрично.
- Ціль — ЦМ ≤ 10 мм від центру: при AUW ≈ 13 кг `|Mx| ≤ 204`, `|My| ≤ 129` кг·мм.

### 24.5 Загальні правила, що лишились з розрахунків конкретного навісного

- Антени нижче 1 ГГц — не ближче λ/4 (83 мм на 900 МГц) до карбону й металу. Кріплення біля них — G10 і PETG.
  Саме тому рейки й поперечки склопластикові, а бортова плита П2 з G10.
- Під дисками гвинтів (за колом R219) навісне перекриває струмінь — туди ставити лише плоске.
- Прямокутне в зоні T розміром як Starlink Mini (298 × 259) — тільки з поворотом на 45°.
- Навісне під рамою опускає ЦМ. Якщо він опиниться глибше ~80 мм під площиною гвинтів, маятникова мода
  лягає в контур утримання позиції → знижувати `PSC_POSXY_P`, `PSC_VELXY_P`.
- Передавачі тримати подалі від щогли GPS (x −230).

### 24.6 Маса клітки

Клітка без навісного: **582 г** (труби 382, вузли 160, кріпіж 40).
Монтажний комплект (П1 + дві П2 + сідла) — 181 г, він рахується в навісне.
