mmazalov/mmazalov.github.io/(commit log)

2019-08-23 изменил файл редми
    Изменил имя
2026-09-18 Add 22" long-endurance FPV build spec with three configurations
    Physics-based sizing for a 22" quad targeting 50-60 min hover at
    1000-1500 m: momentum-theory power model calibrated against DJI M350
    data, altitude density correction, and Li-ion pack current limits.
    Covers three BOMs with Ukrainian pricing (budget 6008, T-Motor MN6007 II
    optimum, MN6012 payload-capable), plus DIY frame geometry for 25x25 mm
    square carbon tube at 1000 mm wheelbase.
    Claude-Session: https://claude.ai/code/session_015QsW7Sit6RtDXsijnkCTvx
2026-09-18 Finalize build on 24" props and DIY frame; add dimensioned layout
    Locks the configuration to 24" folding props with a DIY 1000 mm frame and
    revises the mass budget: 30x30x2 arms are needed for 24" props, so the
    frame is 1421 g rather than the 1030 g estimated for a 25x25 build. Dry
    mass rises to 3.06 kg, but the larger disc more than compensates —
    740 W hover at 1500 m against 804 W on 22".
    Adds arm resonance analysis (blade-pass 82 Hz vs first bending mode
    90.6 Hz quasi-iso / 108.9 Hz UD-dominant), battery sizing showing 12S4P
    as the plateau point, full BOM, ArduCopter parameter set for Li-ion, and
    a dimensioned SVG layout with a CNC-ready centre plate.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
2026-09-18 Add Starlink Mini as optional payload with layout and power constraints
    Models the 1.32 kg / 39 W cost of a Starlink Mini link: hover time drops
    from 59 to 43 min at 12S4P, with mass responsible for 13.7 of the 15.6
    minutes lost. Battery cannot buy it back — MN6007 II caps AUW at 8.64 kg
    for T/W 2.0 and 12S4P already sits at 8.35 kg, so 12S4P stays correct in
    both mission modes.
    Two hard constraints found: the panel's 197.6 mm circumscribed radius
    overlaps the prop disc's 195 mm inner reach, so it must be rotated 45
    degrees (81 mm clearance instead of a 3 mm interference); and 12S peaks
    at 50.4 V against the terminal's 48 V input limit, making a buck
    converter mandatory.
    Also notes that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
2026-09-18 Recompute for 12S 39Ah solid-state pack; aircraft becomes thrust-limited
    At ~1732 Wh the pack roughly doubles available energy for +1 kg over the
    planned 12S4P Li-ion, taking hover from 59 to 98 min without Starlink and
    43 to 69 min with it. The binding constraint flips from energy to thrust,
    which reverses two earlier conclusions.
    MN6012 is now justified, but only in the Starlink configuration: on 6008
    that build sits at T/W 1.84, below the 2.0 floor. Arms also need to go to
    35x35x2 — higher thrust raises blade-pass to 88-98 Hz, leaving only
    1.11-1.24x margin on the 30x30x2 UD tube's 109 Hz mode.
    Flags the open items that govern the result: pack mass (4.3 vs 5.8 kg is
    28 min and the dif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
2026-09-18 Add antenna payload analysis; flag control-link conflict and arm upgrade
    Sizes both antennas from first principles: the 16 dBi horn at 3.3 GHz is
    a 226x226 mm aperture 283 mm long, and a 6-element 900 MHz Yagi has a
    366 mm boom that hangs below the 300 mm legs. Flat equivalents in the
    same bands cost about 1.5 dB and save 430 g, three minutes and most of
    the side area.
    Two findings gate the build. The 900 MHz payload sits 3.7 percent from
    the 868 MHz ELRS control link, which no practical filter can separate, so
    control has to move to 2.4 GHz or MAVLink over Starlink before anything
    is assembled. And at 11.4 kg AUW blade-pass reaches 104.6 Hz, leaving
    1.17x on the 35x35x2 arm — 40x40x2 res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
2026-09-18 Close out configuration at 42 W payload; add consolidated summary
    Both readings of the stated 40 Wh figure land between 37 and 44 W, a
    spread worth under a minute of flight, so the build is closed out at
    42 W. With flat antennas on 26" props the aircraft holds 62 min at
    1500 m with Starlink and both bands live — above the original target,
    now carrying full payload.
    Payload draw turns out to be 3 percent of the power budget, so antenna
    mass governs endurance rather than consumption, the same way it did for
    Starlink. The 150 W payload converter is sized from the RF amplifier's
    3-5x peak factor, not from the 42 W average.
    Adds a consolidated configuration section at the top so the spec can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
2026-09-19 Identify the actual cell; energy confirmed, pack mass still open
    The label reads WESTINGHOUSE LI-ION CELL, INP1187187, 39Ah 175A 3.7V
    144.3Wh — a conventional Li-ion pouch rather than the solid-state
    assumed in sections 9-11. Energy matches exactly at 1732 Wh for 12S1P,
    and the 175 A rating settles the C-rate question that was flagged as a
    possible showstopper: hover draws 0.88C against a 4.5C limit.
    Pack mass remains the open variable and spans 45 to 62 min, with the
    T/W 2.0 floor crossed around 6.8 kg. Two cross-checks argue for caution:
    at the decoded 11x87x187 mm the cell implies 806 Wh/L and roughly
    350 Wh/kg, both beyond series Li-ion, so either the case code parses
    differently or t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
2026-09-19 Add priced BOM, FC selection, vibration mount and payload cage
    Prices the whole build at 170-187k UAH with links to Ukrainian sellers,
    fasteners itemised, excluding the repeater and antennas themselves.
    F722 is ruled out on flash: STM32F722 carries 512 KB against ArduCopter's
    1 MB minimum, so it runs only Betaflight or INAV, neither adequate for a
    12 kg aircraft holding position autonomously for most of an hour. Settles
    on Matek H743-SLIM V3, and adds the companion computer that MAVLink over
    Starlink requires and that earlier sections had missed.
    Vibration isolation turns out to need deliberate design rather than the
    usual balls: at 46.6 Hz rotor frequency a bare FC on standard silicone
    si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
2026-09-19 Move to Pixhawk 6X + CM4 and 28in props; add general arrangement drawing
    The Pixhawk RPi CM4 Baseboard replaces the H743, the separate Pi Zero
    companion and the damping platform's ballast for a net 60 g, and brings
    triple isolated IMUs with heaters — which matters over 50 minutes at
    1500 m, where gyro temperature drift is what makes Loiter wander. The
    215 g stack is heavy enough on its own to reach 12.6 Hz on the same soft
    mounts, so no ballast is needed.
    Adding the ZR10 puts 26" props below the T/W 2.0 floor on either reading
    of the gimbal's mass, which sources give as 381 g or about 920 g. Going
    to 28" on a 1150 mm base restores margin to 2.2 and adds three minutes,
    since the larger dis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
2026-09-19 Add power and data architecture with block diagram
    Works the electrical design out to wire gauges: 8 AWG main at 171 A peak,
    12 AWG per arm, and four separate rails. The gimbal gets its own 12 V
    supply rather than sharing the repeater's, because an RF amplifier with a
    3-5x peak factor would dip the rail on every transmission and make the
    gimbal twitch — defeating the point of the camera.
    Two components surface that the BOM did not have. The current sensor must
    read 171 A, so PM02D at 60 A is out and a Mauch HS-200-HV hall sensor
    replaces it. And CM4 has a single Ethernet port against three clients
    (Starlink, ZR10, Pixhawk 6X), so a 4-port switch is needed.
    Also locks DJI O4 to 5.8 GHz: i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
2026-09-22 Add scaled A3 sketch set as PDF with its generator
    Four sheets at scale — top view with ArduCopter motor order, side and
    front views with numbered callouts, a 16-item parts list, the payload
    plan and a drilled centre plate. The generator lives in fpv/tools so the
    set can be rebuilt once the cell, gimbal and repeater are weighed.
    Drawing to scale surfaced three problems the calculations had not. The
    Yagi at x=-140 sat exactly where the rear landing leg passes, so it moves
    to x=-40, 89 mm from the leg and clear of quarter-wave detuning. The
    210x200 plate cannot hold 50 mm tube clamps without bolts breaking the
    edge, so it grows to 250x250 with a built-in check for edge distance,
    web between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
2026-09-22 Add CNC-ready DXF for top and bottom centre plates
    Moves plate geometry into fpv/tools/plate_geometry.py as the single
    source for both the DXF and sheet 4 of the PDF sketch, so the drawing and
    the cut file cannot drift apart.
    Each plate is checked before writing — edge distance at least 1.5d, webs
    of 6 mm between features, nothing under the arm clamps, and the plate
    staying in one piece — then read back after writing: audit, hole count,
    extents, and the area of every contour against the reference. The area
    check is what catches a bulge with the wrong sign, which is invisible at
    thumbnail size.
    A semicircular notch on the front edge marks the nose as a physical cut
    rather than an engrav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
    [plate_bottom.dxf, plate_top.dxf]
2026-09-22 Add payload cage drawings and plate DXF; re-lay payload for Yagi clearance
    Modelling the cage in 3D showed the Yagi elements 42 mm from the metal
    horn — a mechanical gap earlier called acceptable, but well inside a
    quarter wave at 900 MHz, enough to pull the antenna off frequency. The
    payload is re-laid: horn aft to x=-185, Yagi to x=+30 y=-130, repeater
    to x=+20 y=+110. The Yagi now clears the horn, gimbal, repeater and legs
    by at least a quarter wave; the battery above the reflector (56 mm) and
    the skid (82 mm) remain, both noted with a VSWR check on the assembled
    aircraft.
    Rails, crossbars and the repeater tray become G10 so nothing conductive
    sits near the elements, and joints near th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
    [cage_horn.dxf, cage_tray.dxf, cage_zr10.dxf]
2026-09-22 Replace specific payload with installation zones and a payload budget
    Payload will be sized by the owner, so the cage now defines zones rather
    than placing particular devices: nose A, centre B, tail C, the leg
    corridors D, the top zone T over the upper plate and the avionics bay V.
    Each lower zone is checked in 3D against legs, skids and the battery
    cassette across its full travel, keeping at least 10 mm from structure
    and 30 mm from the ground.
    Mounting becomes generic: saddles anywhere on the G10 rails, crossbars
    wherever needed outside the leg corridors, and two universal plates on a
    20 mm M3 grid replacing the three device-specific ones. The bottom plate
    gets 60 mm slots so the battery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
    [cage_plate_center.dxf, cage_plate_side.dxf, cage_tray.dxf, plate_bottom.dxf, plate_top.dxf]
